hotchk155/Voici-Le-Strum/images/DSC02167.JPG

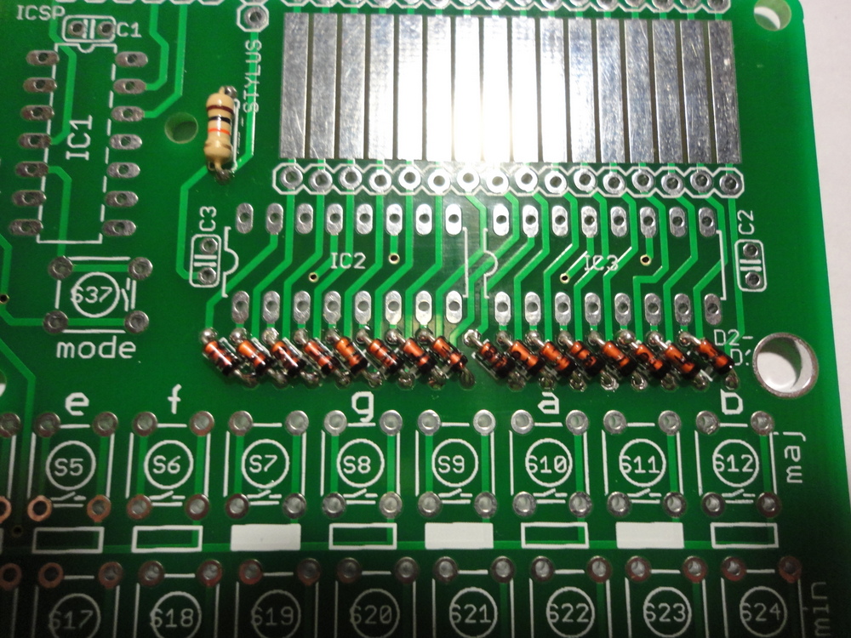
images/DSC02167.JPG
