hotchk155/Voici-Le-Strum/images/Dsc02171.jpg

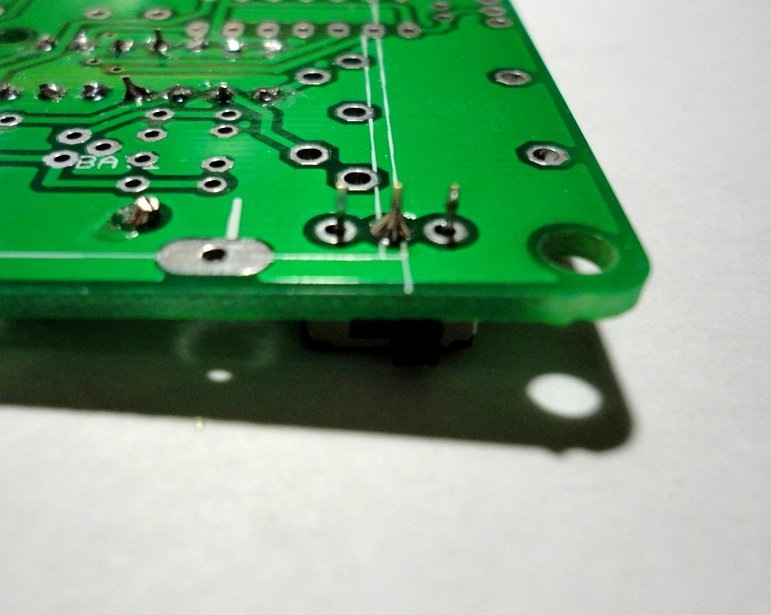
images/Dsc02171.jpg
