hotchk155/Voici-Le-Strum/README.md

LE STRUM is a MIDI strummed chord control surface built around the PIC16F1825 microcontroller. 

The Le Strum documentation is at [http://six4pix.com/lestrum/](http://six4pix.com/lestrum/)
