hotchk155/Voici-Le-Strum/docs/quick ref.odt

Preset Patch (Hold MODE Button) | Command (Hold MODE Button) | Toggle Setting (Hold MODE Button) Single blink OFF, Double blink ON | LE STRUM QUICK REF V4

| | C | C# | D | D# | E | F | F# | G | G# | A | A# | B
MAJ | | Basic Strum Mode | | Guitar Strum Mode | | Guitar Sustain Mode | Organ Buttons Mode | | Organ Buttons with Adds | | Organ Buttons with Adds/Retrig | | Load User Patch From EEPROM
MIN | | Play Note On Contact Make | Play Note On Contact Break | Guitar Open Chord Voicing | Added Notes (Sus4/6/9) | Sustain Chord Until Next Chord | Chromatic Scale On Pads | | Enable Organ Buttons On MIDI Ch 2 | Sustain O/B Until Next Chord | | Toggle Strum Direction | Save User Patch To EEPROM
DOM7 | | Damp Note On Contact Make | Damp Note On Contact Break | Repeat Guitar Chord At +1 Octave | Map Guitar Chord Bass Notes | Common Notes Sustain On Change | Diatonic Scale On Pads | Pentatonic Scale On Pads | | Common Notes Sustain On O/B | | Toggle Circle Of 5ths Mode | MIDI Panic (All Notes Off)
| | C | C# | D | D# | E | F | F# | G | G# | A | A# | B
C. of 5ths | | Db | Ab | Eb | Bb | F | C | G | D | A | E | B | F#

Special Chord Button Combinations ● MAJ + DOM7 = Major Seventh Chord ● MIN + DOM7 = Minor Seventh Chord ● MAJ + MIN = Diminished Triad ● MAJ + MIN + DOM7 = Augmented Triad | Added Notes (When enabled by Mode) ● Hold chord and press top row button to right = Sus 4 ● Hold chord and press middle row button to right = Add 6 ● Hold chord and press bottom row button to right = Add 2/9 | ● Hold MODE and touch a pad with the stylus to set MIDI velocity ● Hold MODE at startup to flash firmware version number ● Strum output on MIDI channel 1 at controllable velocity ● Organ button output on MIDI channel 2 at full velocity
