hotchk155/Voici-Le-Strum/docs/le strum.odt

Le Strum is a MIDI strum controller

Stop playing when

As soon as chord button is pressed, the notes of the chord will play on MIDI channel 2 and will stop when the button is release

| OFF | ON
Pluck Mode | Note starts to play when a chord is held and stylus touches the note. Note stops playing when stylus stops touching the note

Added notes

Press higher note on row #1 – sus4

Press higher note on row #2 – add6

Press higher note on row #3 – add9

Stacked triads mode

Guitar chord mode

Alternate with octave

Notes stop after chord is released. If changing to another chord, unmatched notes are muted

Notes continue to ring after chord is released but when a new chord is pressed, unmatched notes are muted

Guitar

PLUCK

RING ON

ADDED NOTES

Mute Guitar

PLUCK

ADDED NOTES

Stacked Triads

PLUCK OFF

RING ON

ADDED NOTES

Muted Stacked Triads

PLUCK OFF

ADDED NOTES

Le Strum has 7 patches (C, D, E, F, G, A, B from left to right on the keyboard)

To switch between patches simply hold the MODE button and press one of the chord buttons in the top row for notes C, D, E, F, G, A or B. When selected, the MODE LED will flash a sequence of flashes indicating the selected patch, for a total of three repetitions of the sequence.

C | 1
D | 2
E | 3
F | 4
G | 5
A | 6
B | 7

The default patches are as follows

The patches can be customised. To do this you need to hold down the MODE button before powering on LE STRUM. This will enter patch edit mode.

In patch edit mode, select a patch to edit by holding MODE and pressing one of the top row chord buttons C,D,E,F,G,A,B. During programming mode the MODE LED blinks to indicate the patch that is being edited. You can change to another patch by holding MODE and pressing a different top row chord key.

Each patch has a number of settings associated with it. When you have selected a patch you can manipulate its settings as follows

- To view a setting press the top row chord button corresponding to the setting. The MODE LED will show steady ON or OFF
- To turn a setting ON press the top row chord button corresponding to the setting
- To turn a setting OFF press the top row chord button corresponding to the setting

To save settings to the current patch, press and hold MODE until it lights steadily for ~1s. Once all saves are done, you can power down LE STRUM and power back up for normal operation

Chord Mapping Options

VELOCITY

MIDI velocity for strumming can be controlled by holding the MODE button while touching one of the pads with the stylus. The first (leftmost) pad sets MIDI velocity to its minimum value and each pad increases the velocity up to its maximum value on the right most pad. The selected velocity stays effective until LE STRUM is switched off or a new velocity is chosen.

DYNAMICS

Pluck Mode: Start playing note when stylus breaks contact with pad.

Sustain Mode: Start playing note when stylus makes contact with pad.

Pluck/Damp Mode: Start playing note when stylus breaks contact with pad and stop note playing when stylus touches the pad again

Organ Mode: Start playing note when stylus makes contact with pad and stop note playing when stylus breaks contact with pad

Chord Setup Options

ORGAN BUTTONS

ON: The chord start to play when the chord button is first pressed, even when no strumming has taken place. When buttons are released the behaviour depends on the RING ON settng.

OFF: When changing chords, all notes from the previous chord are stopped

Organ button mode plays only the chord triad and higher octave of the selected chord.

ADDED NOTES

ON: While a chord is held, pressing another chord button further up the scale (to the right) will add notes to the chord. Row 1 = sus4, row 2 = add6, row 3 = add9.

Note that there some limitations to the use of added notes; obviously there is no higher button for the top "B" column, and the mapping of the chord notes to strings will change, with the root note playing again when the string corresponding to the column of the highest button is played.

OFF: The chord in the lowest column is used. Buttons held in any column to the right (higher up the scale) are ignored. This is useful when you want to change from one chord to another without releasing the first.

COMMON NOTE SUSTAIN

OFF: Changing from one chord to another will always stop all notes in the previous chord before starting notes in the new chord.

ON: When changing from one chord to another (without releasing the chord buttons) any notes which are common to both chords are not stopped but continue to ring.

RING ON

OFF: When all chord buttons are released, all notes will be stopped

ON: When all chord buttons are released, any notes still playing will ring on until a new chord is pressed (and will then be subject to common note sustain setting)

GUITAR MODE

ON: Typical guitar chord fingerings are used when mapping notes to the pads. The lowest 6 pads are standard register and the topmost 6 pads are one octave higher. The middle 2 pads are inactive. Depending on the chosen chord other pads may be inactive too (corresponding to the damped strings in the usual guitar chord fingering)

OFF: Notes of a chord are mapped to the pads using the stacked triads approach. All pads are active.

STRING MAPPING

NORMAL: Chord notes are assigned to pads 1 by 1

OCTAVE PAIRING: Chord notes are interlaced with notes 1 octave higher (i.e. Every other pad plays a note 1 octave higher than the pad to its left). The idea is to have something similar to a 12 string guitar.

NOTE DOUBLING: Chord notes are duplicated (i.e. Every other pad plays the same note as the pad to its left).

NOTE SPREAD: Chord notes are separated with a dead string (i.e. Every other pad is not mapped to any note).

In Guitar mode any mapping other than "normal" will disable the higher chord mapping.

- Le Strum outputs on MIDI channel 1 at the user controlled velocity
- Chord Buttons are output on MIDI channel 2 at full velocity

Play on Make | Play on Break | Guit | Add | Sus | Scale | | | | Drone | Sus Drone | Save
Stop on Make | Stop on Break | Guit2 | Bass | Sus Comm | Dia | Pent | | | | Sus Drone Comm | Load
