hotchk155/Voici-Le-Strum/hardware/board_render.png

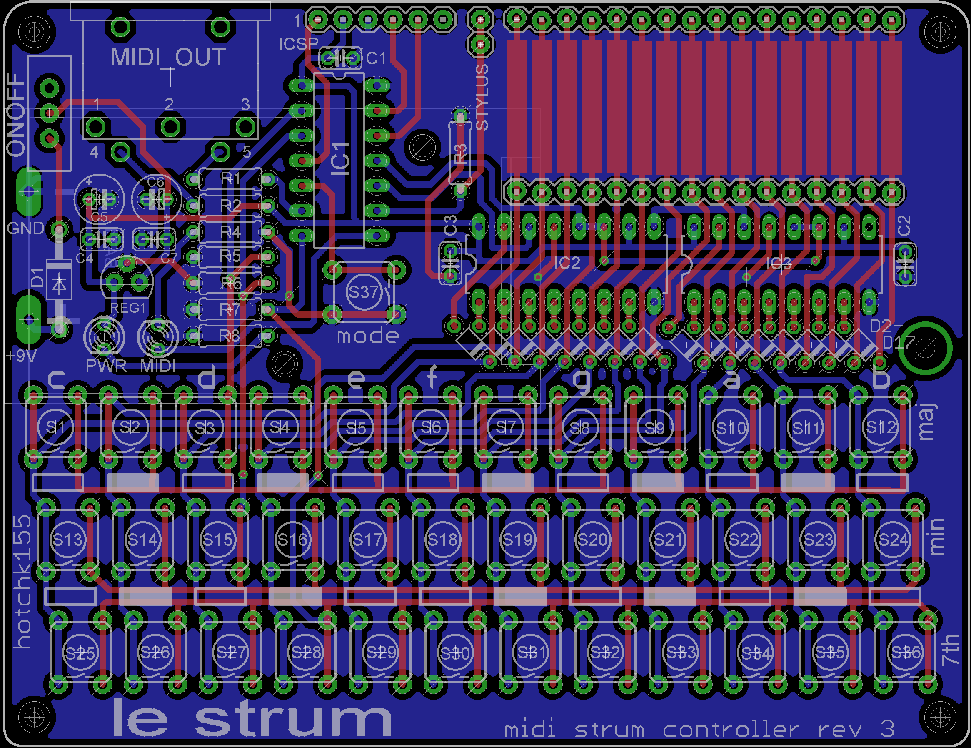
hardware/board_render.png
