hotchk155/Voici-Le-Strum/hardware/schematic_render.png

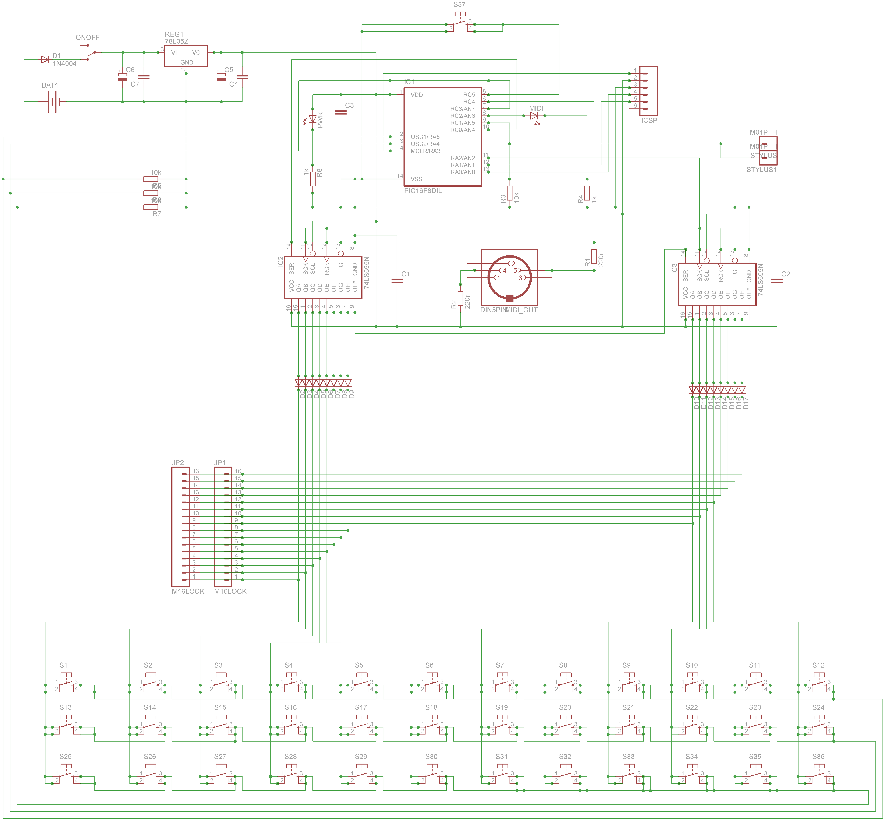
hardware/schematic_render.png
