hotchk155/Voici-Le-Strum/images/Dsc02149.jpg

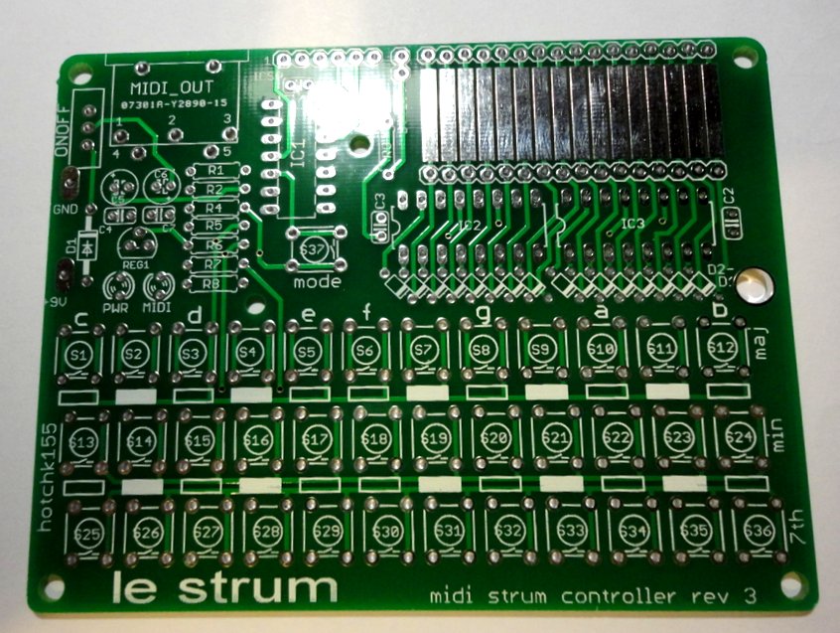
images/Dsc02149.jpg
