hotchk155/Voici-Le-Strum/images/Dsc02150.jpg

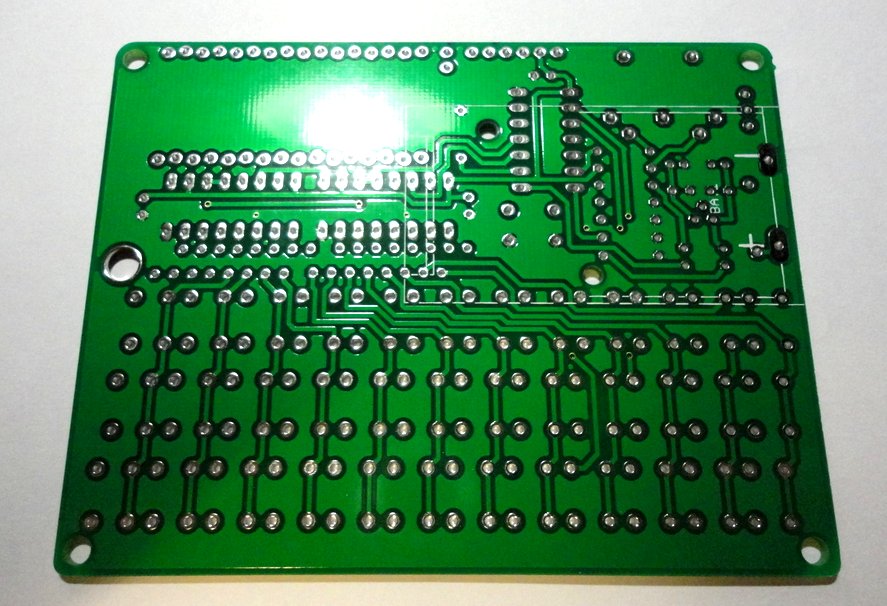
images/Dsc02150.jpg
