hotchk155/Voici-Le-Strum/images/Dsc02153.jpg

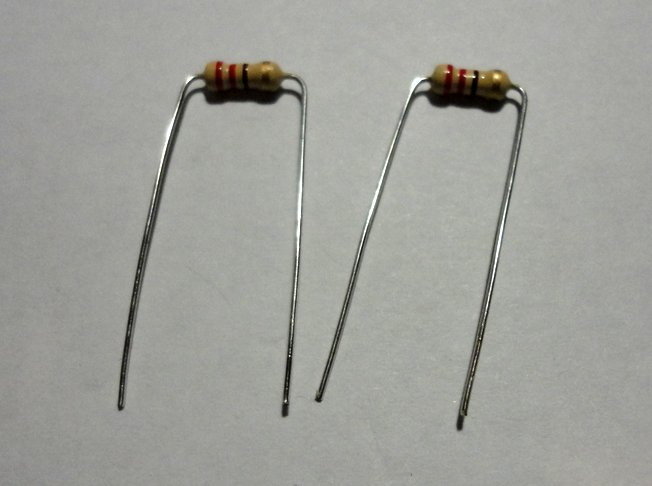
images/Dsc02153.jpg
