hotchk155/Voici-Le-Strum/images/Dsc02159.jpg

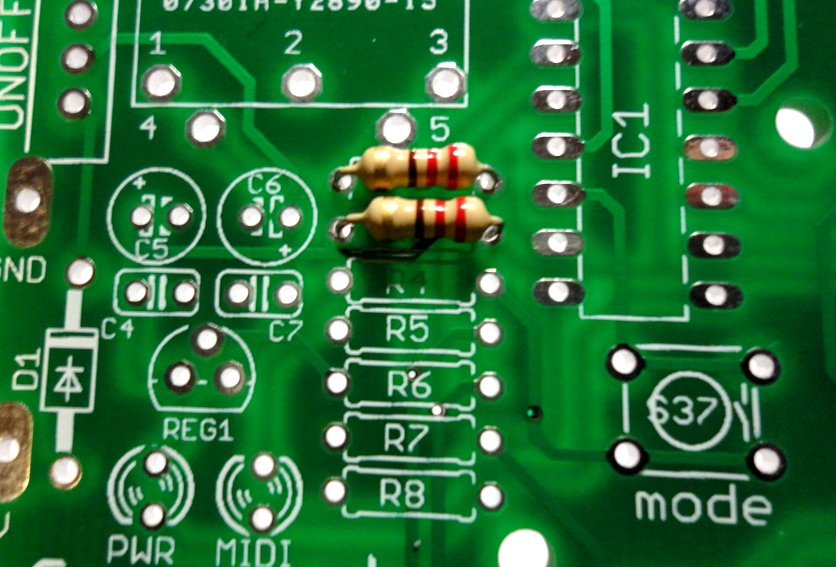
images/Dsc02159.jpg
