hotchk155/Voici-Le-Strum/images/Dsc02160.jpg

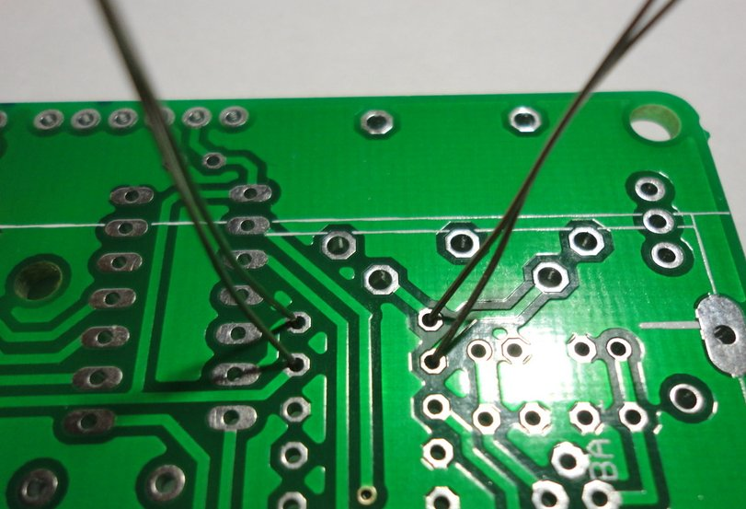
images/Dsc02160.jpg
