hotchk155/Voici-Le-Strum/images/Dsc02161.jpg

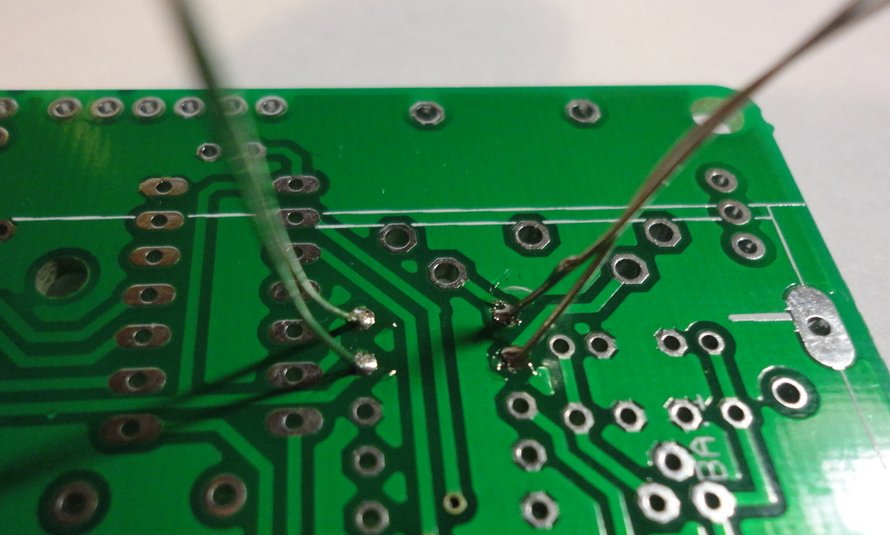
images/Dsc02161.jpg
