hotchk155/Voici-Le-Strum/images/Dsc02162.jpg

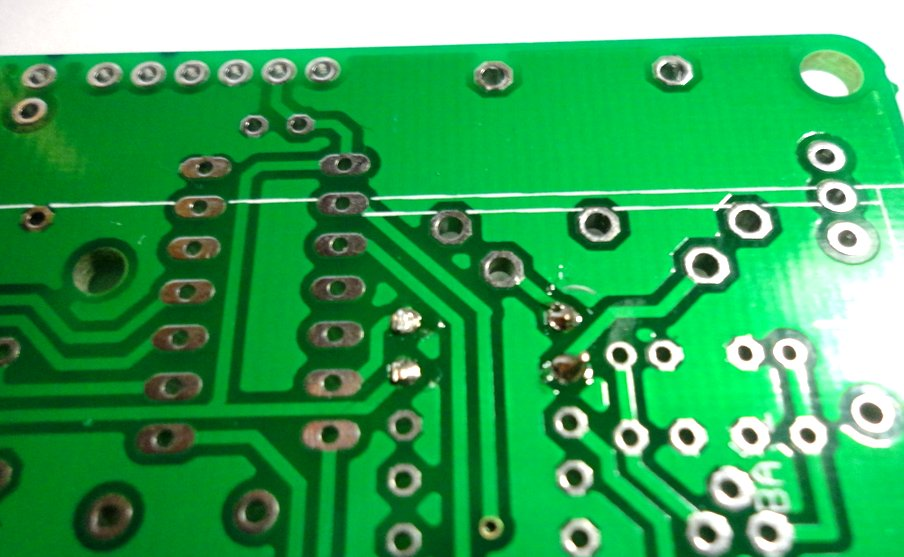
images/Dsc02162.jpg
