hotchk155/Voici-Le-Strum/images/Dsc02163.jpg

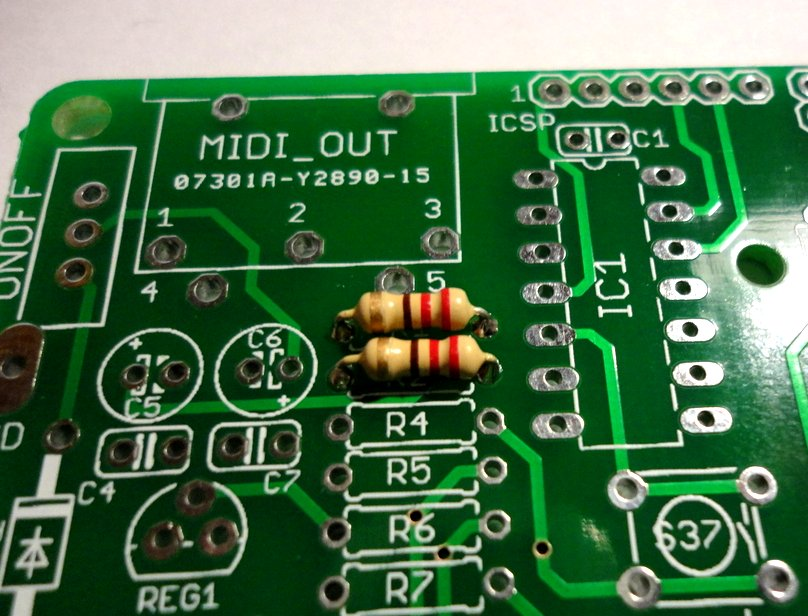
images/Dsc02163.jpg
