hotchk155/Voici-Le-Strum/images/Dsc02164.jpg

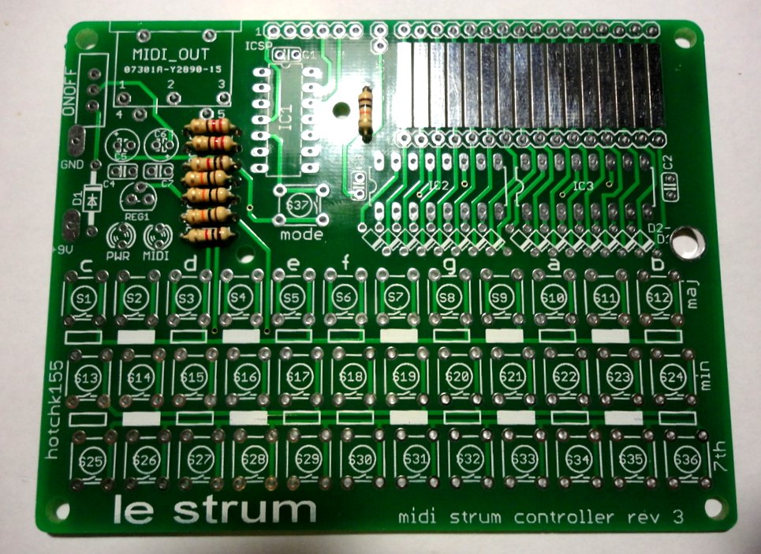
images/Dsc02164.jpg
