hotchk155/Voici-Le-Strum/images/Dsc02172.jpg

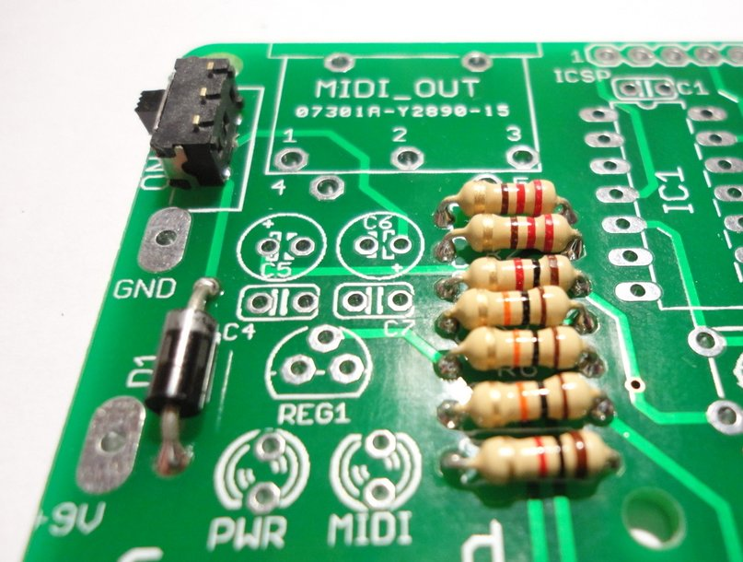
images/Dsc02172.jpg
