hotchk155/Voici-Le-Strum/images/Dsc02174.jpg

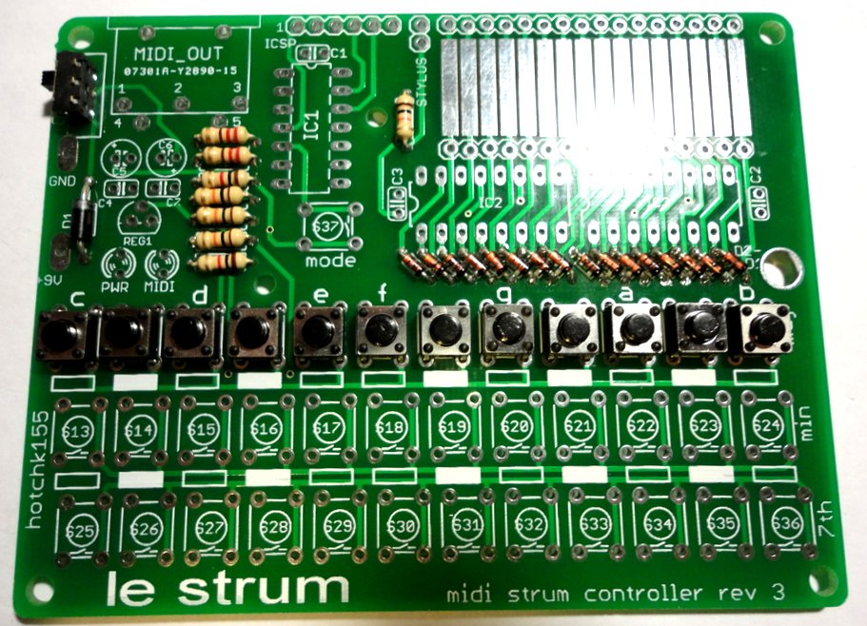
images/Dsc02174.jpg
