hotchk155/Voici-Le-Strum/images/Dsc02175.jpg

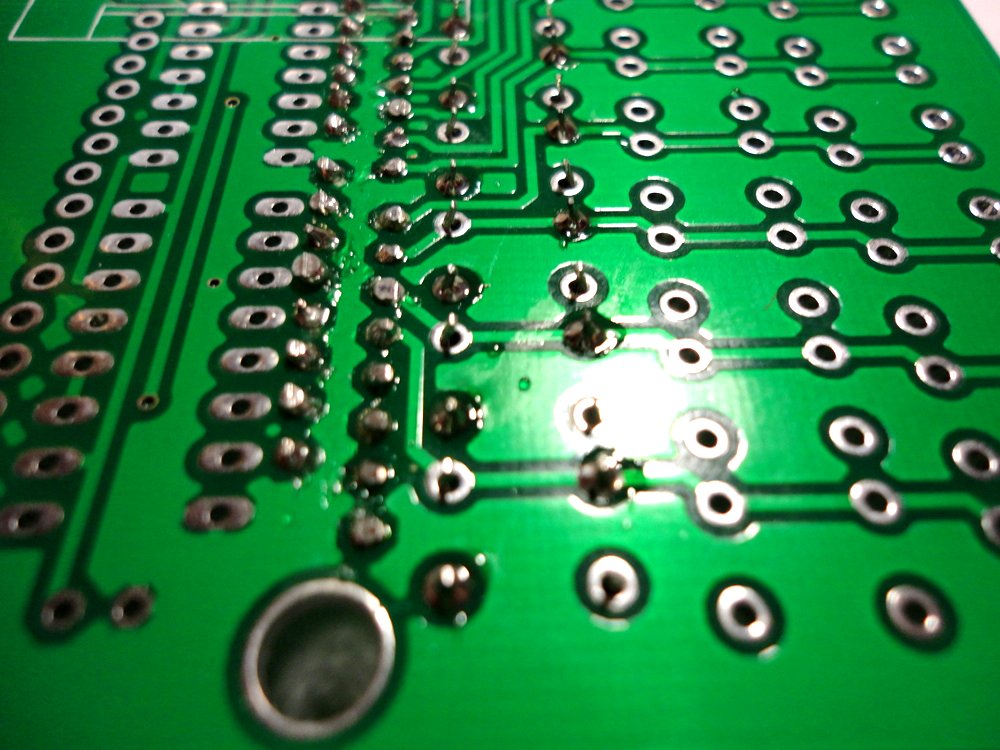
images/Dsc02175.jpg
