hotchk155/Voici-Le-Strum/images/Dsc02176.jpg

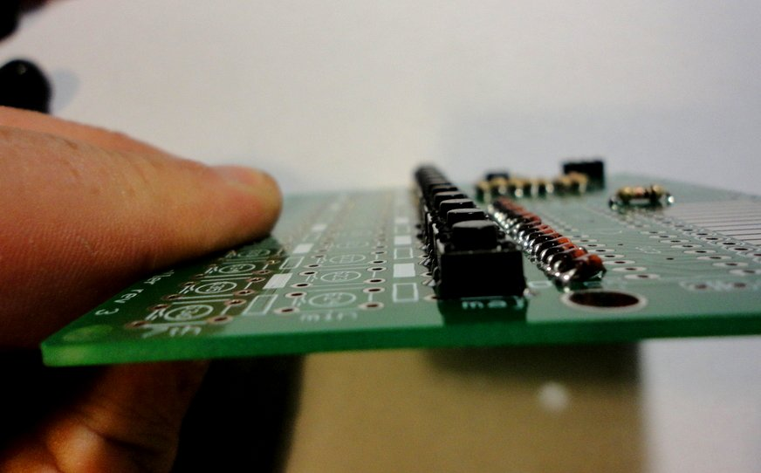
images/Dsc02176.jpg
