hotchk155/Voici-Le-Strum/images/Dsc02182.jpg

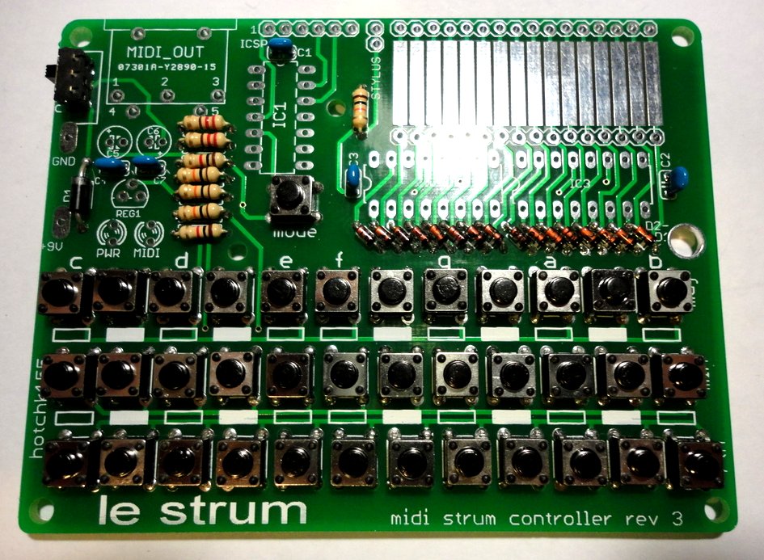
images/Dsc02182.jpg
