hotchk155/Voici-Le-Strum/images/Dsc02185.jpg

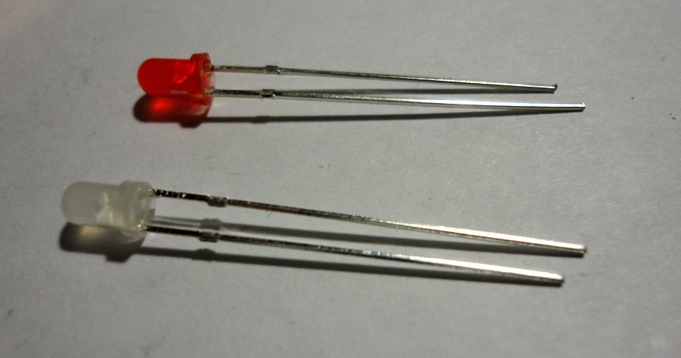
images/Dsc02185.jpg
