hotchk155/Voici-Le-Strum/images/Dsc02186.jpg

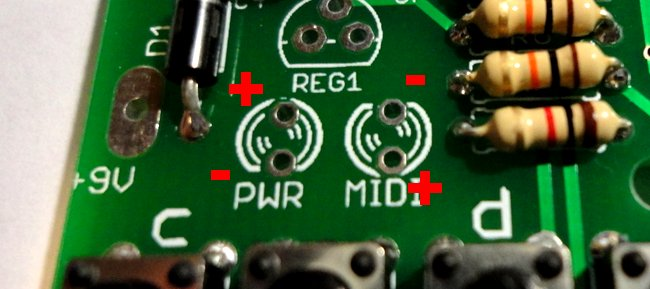
images/Dsc02186.jpg
