hotchk155/Voici-Le-Strum/images/Dsc02187.jpg

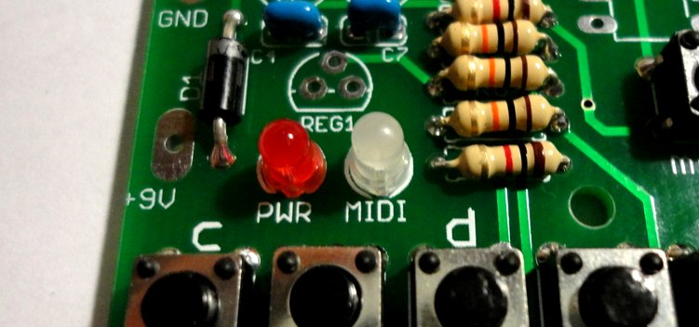
images/Dsc02187.jpg
