hotchk155/Voici-Le-Strum/images/Dsc02189.jpg

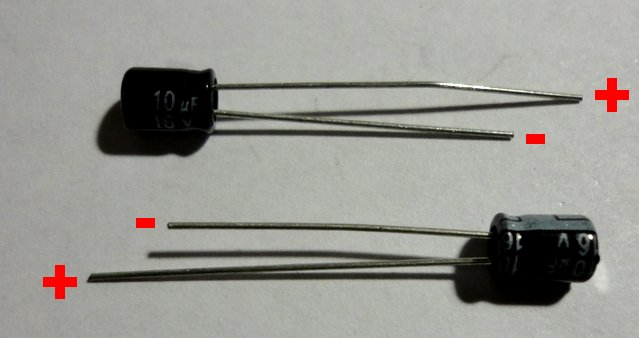
images/Dsc02189.jpg
