hotchk155/Voici-Le-Strum/images/Dsc02191.jpg

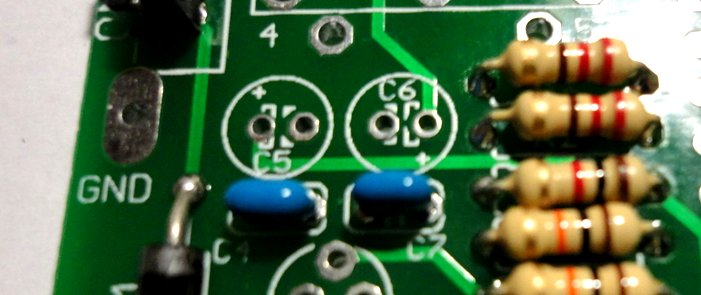
images/Dsc02191.jpg
