hotchk155/Voici-Le-Strum/images/Dsc02194.jpg

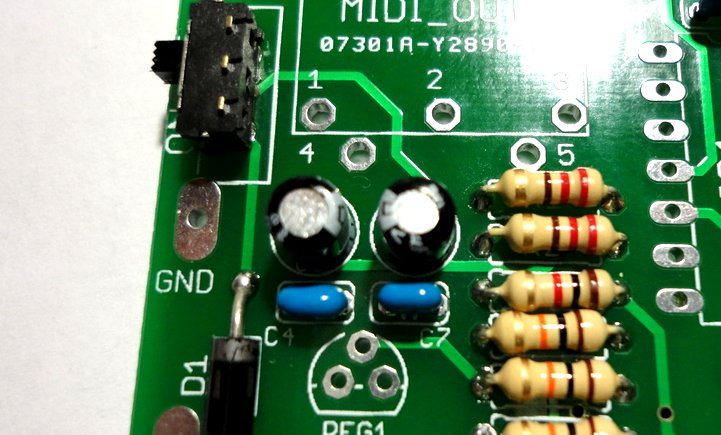
images/Dsc02194.jpg
