hotchk155/Voici-Le-Strum/images/Dsc02195.jpg

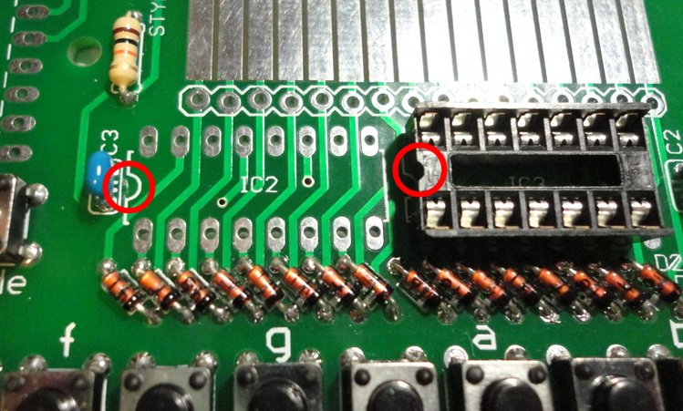
images/Dsc02195.jpg
