hotchk155/Voici-Le-Strum/images/Dsc02200.jpg

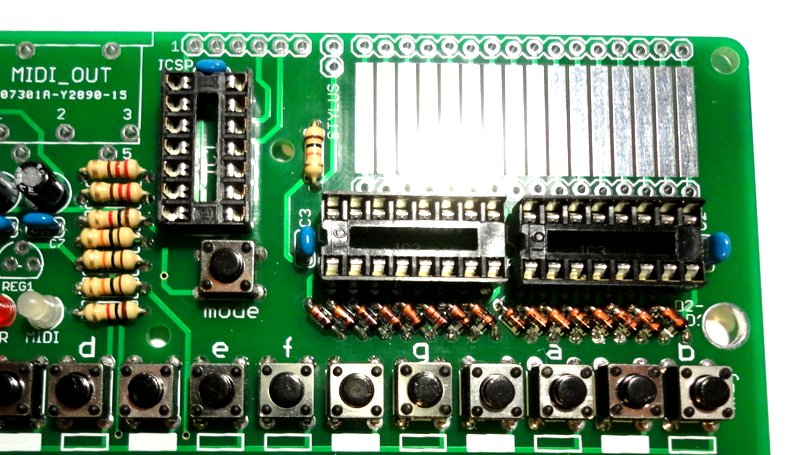
images/Dsc02200.jpg
