hotchk155/Voici-Le-Strum/images/Dsc02203.jpg

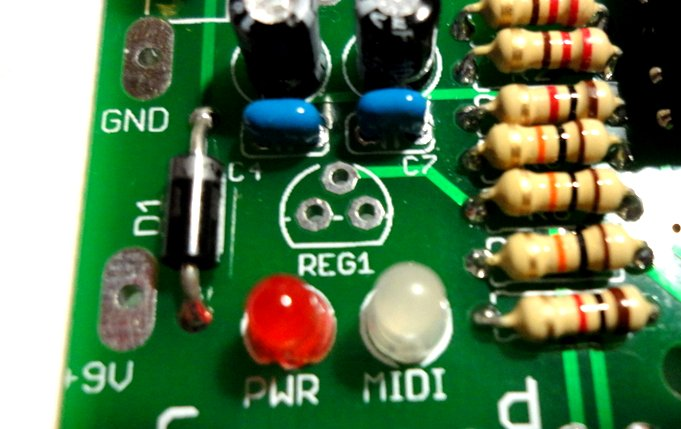
images/Dsc02203.jpg
