hotchk155/Voici-Le-Strum/images/Dsc02204.jpg

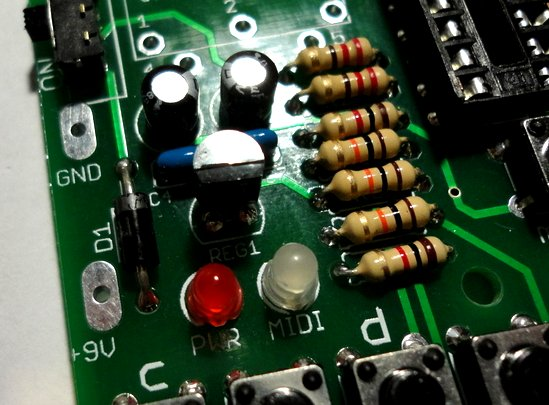
images/Dsc02204.jpg
