hotchk155/Voici-Le-Strum/images/Dsc02206.jpg

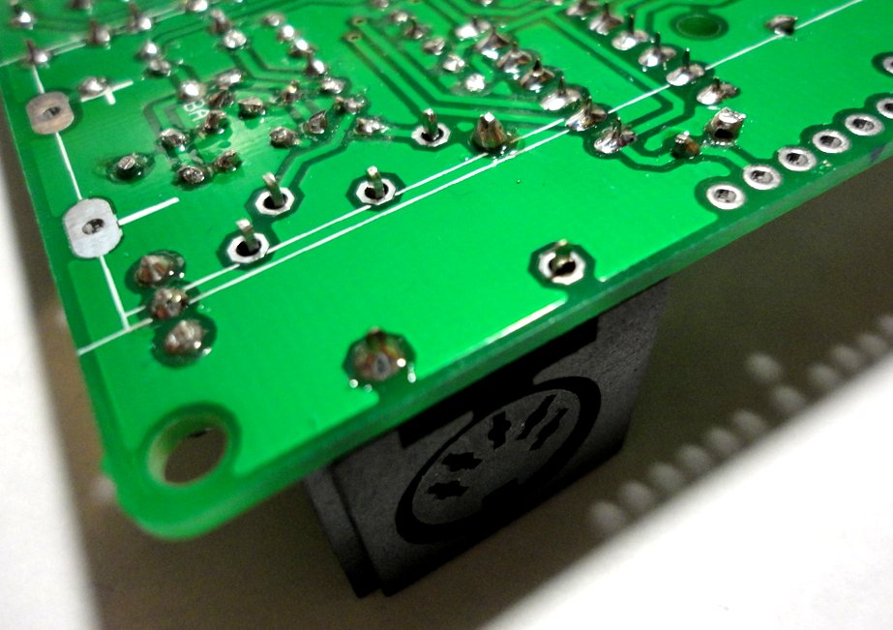
images/Dsc02206.jpg
