hotchk155/Voici-Le-Strum/images/Dsc02207.jpg

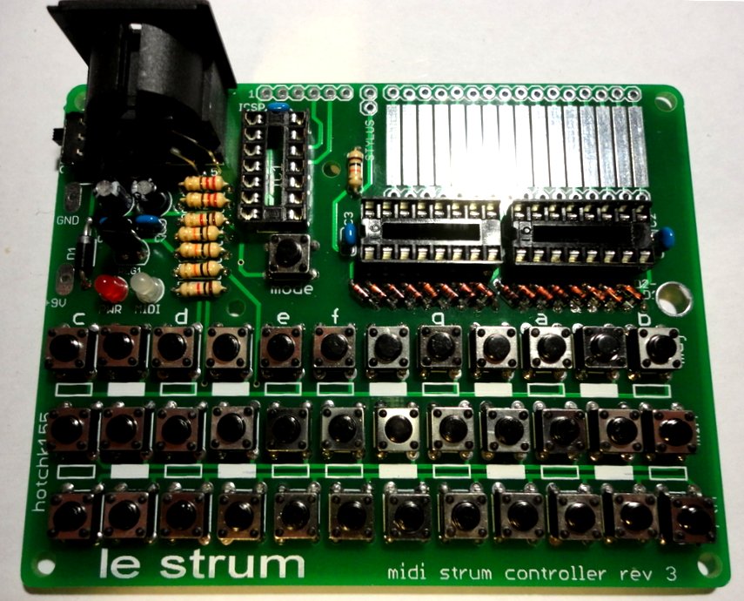
images/Dsc02207.jpg
