hotchk155/Voici-Le-Strum/images/Dsc02209.jpg

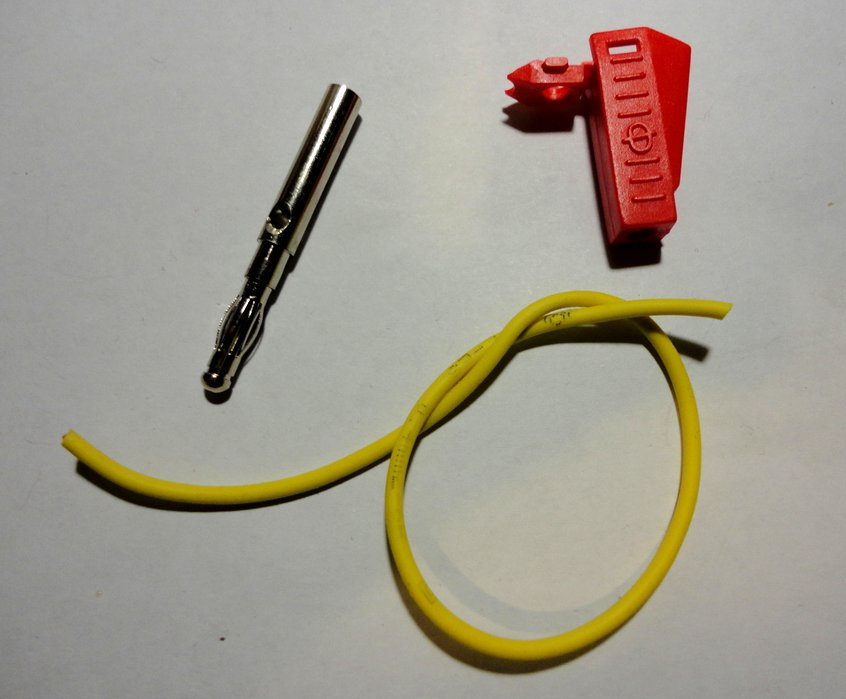
images/Dsc02209.jpg
