hotchk155/Voici-Le-Strum/images/Dsc02211.jpg

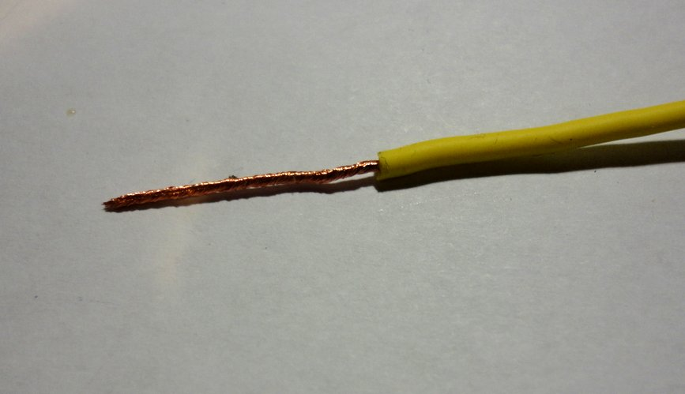
images/Dsc02211.jpg
