hotchk155/Voici-Le-Strum/images/Dsc02213.jpg

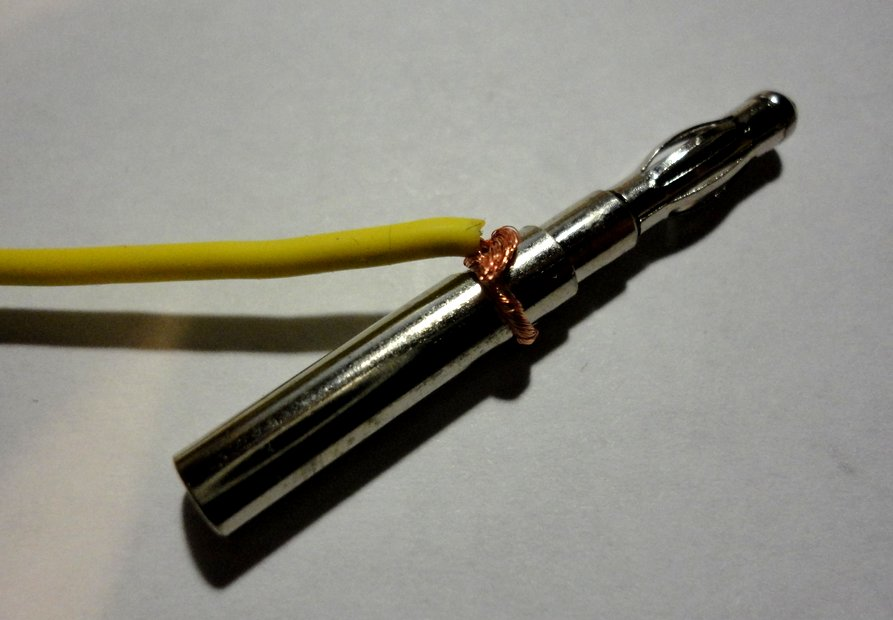
images/Dsc02213.jpg
