hotchk155/Voici-Le-Strum/images/Dsc02218.jpg

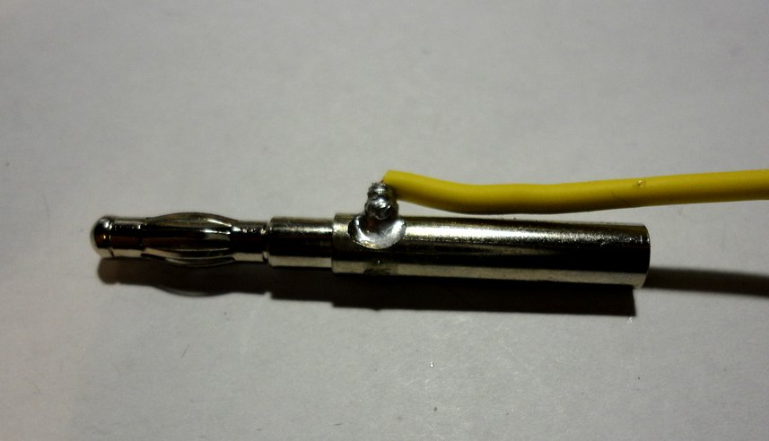
images/Dsc02218.jpg
