hotchk155/Voici-Le-Strum/images/Dsc02220.jpg

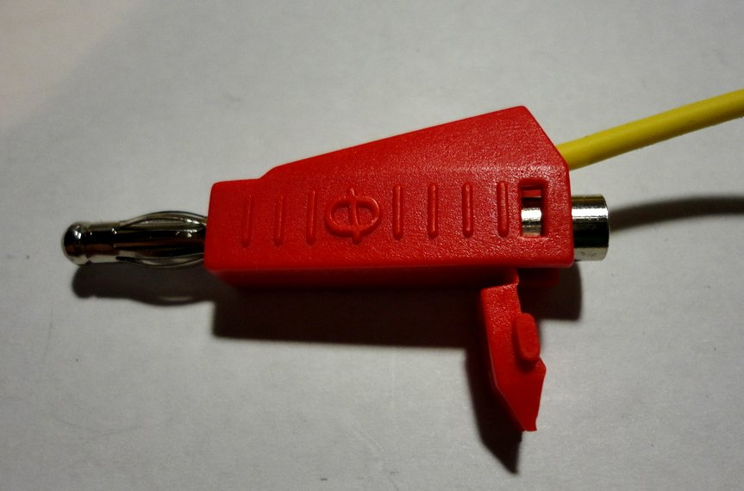
images/Dsc02220.jpg
