hotchk155/Voici-Le-Strum/images/Dsc02222.jpg

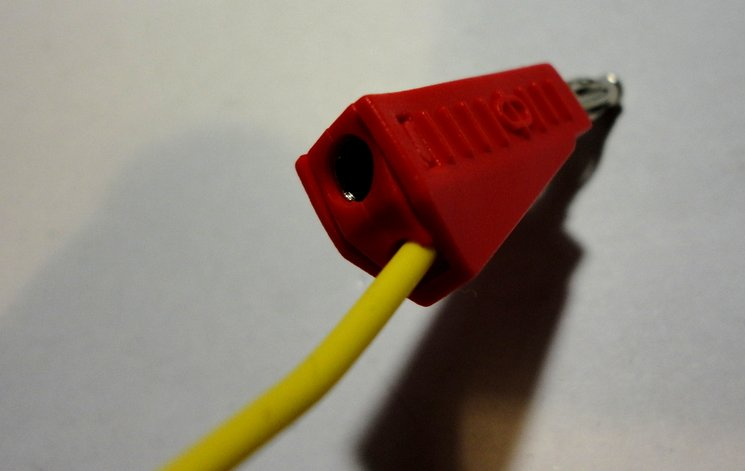
images/Dsc02222.jpg
