hotchk155/Voici-Le-Strum/images/Dsc02223.jpg

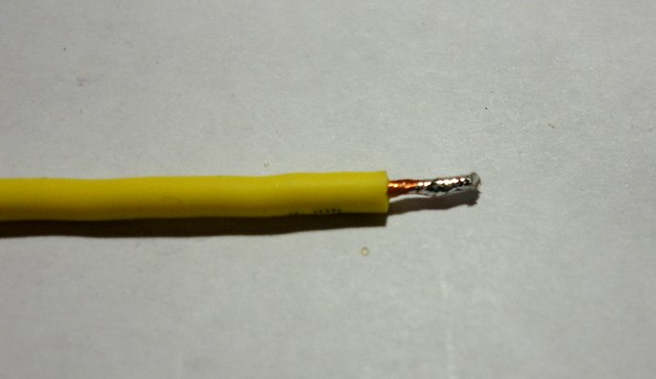
images/Dsc02223.jpg
