hotchk155/Voici-Le-Strum/images/Dsc02224.jpg

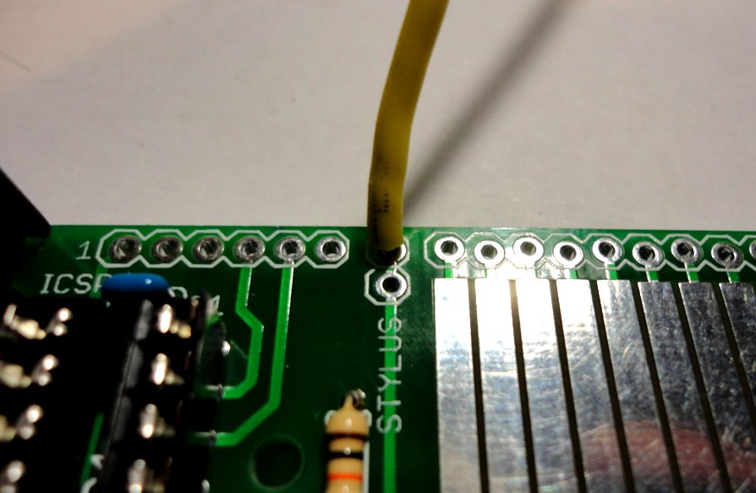
images/Dsc02224.jpg
