hotchk155/Voici-Le-Strum/images/Dsc02226.jpg

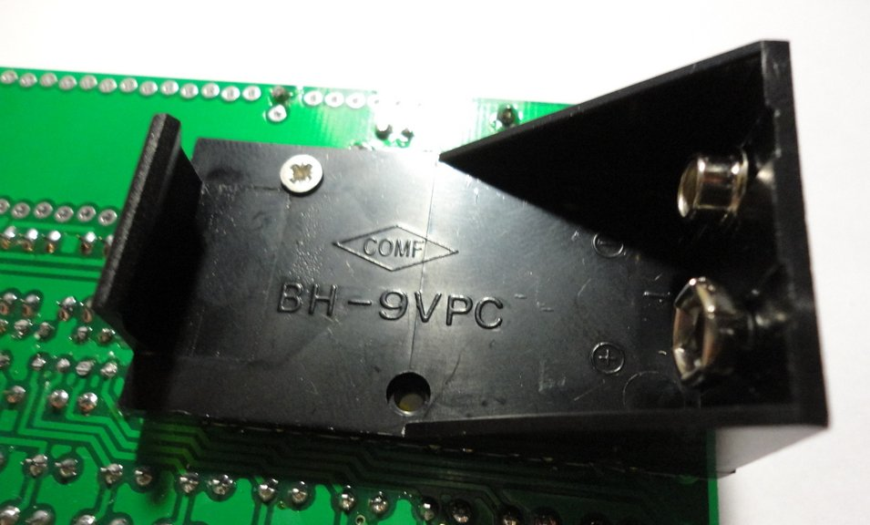
images/Dsc02226.jpg
