hotchk155/Voici-Le-Strum/images/Dsc02228.jpg

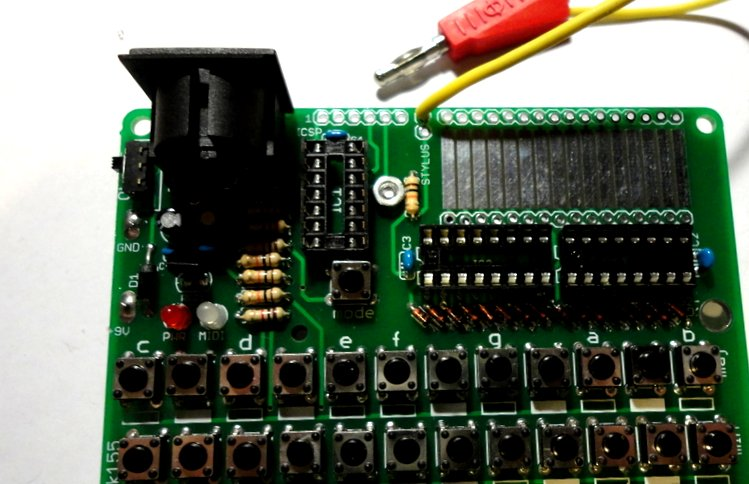
images/Dsc02228.jpg
