hotchk155/Voici-Le-Strum/images/Dsc02232.jpg

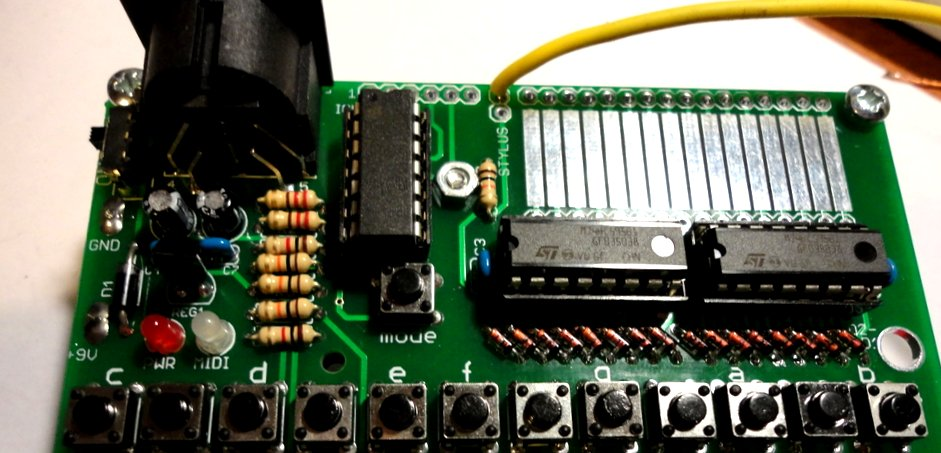
images/Dsc02232.jpg
