hotchk155/Voici-Le-Strum/images/Dsc02274.jpg

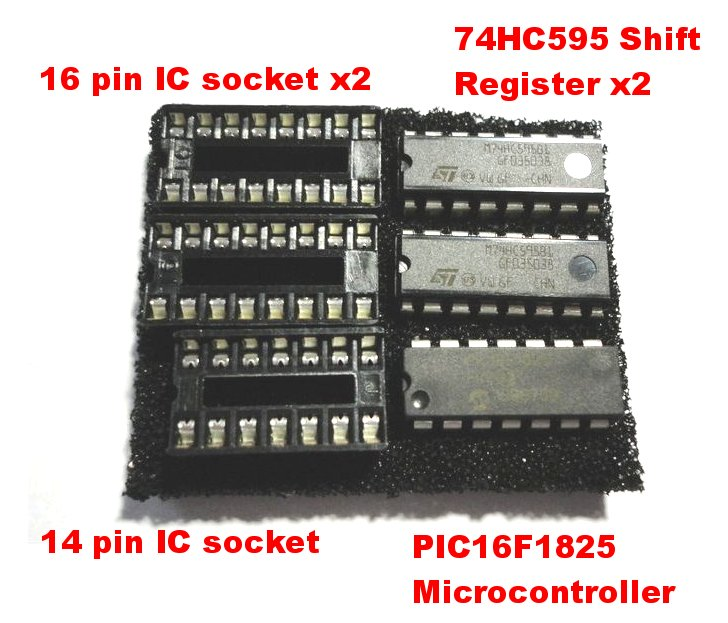
images/Dsc02274.jpg
