hotchk155/Voici-Le-Strum/images/Dsc02278.jpg

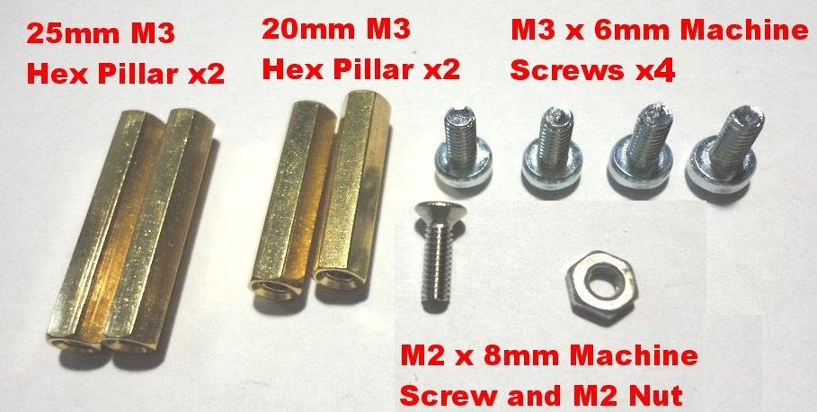
images/Dsc02278.jpg
