hotchk155/Voici-Le-Strum/images/Dsc02281.jpg

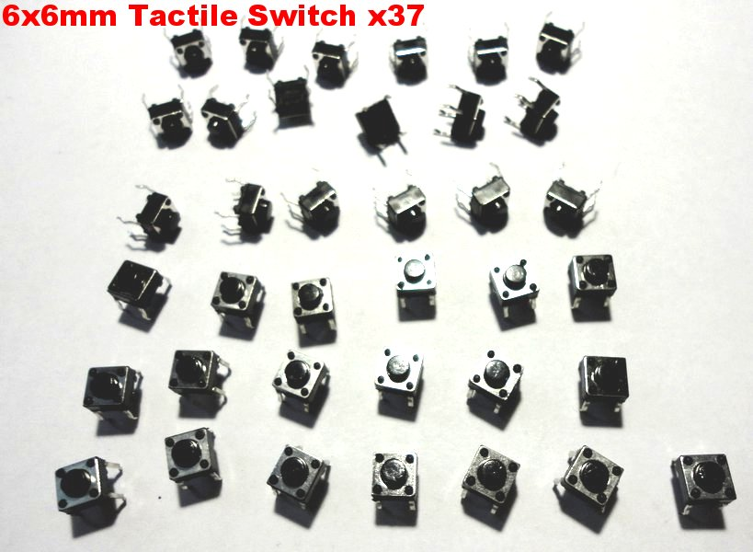
images/Dsc02281.jpg
