hotchk155/Voici-Le-Strum/images/Dsc02284.jpg

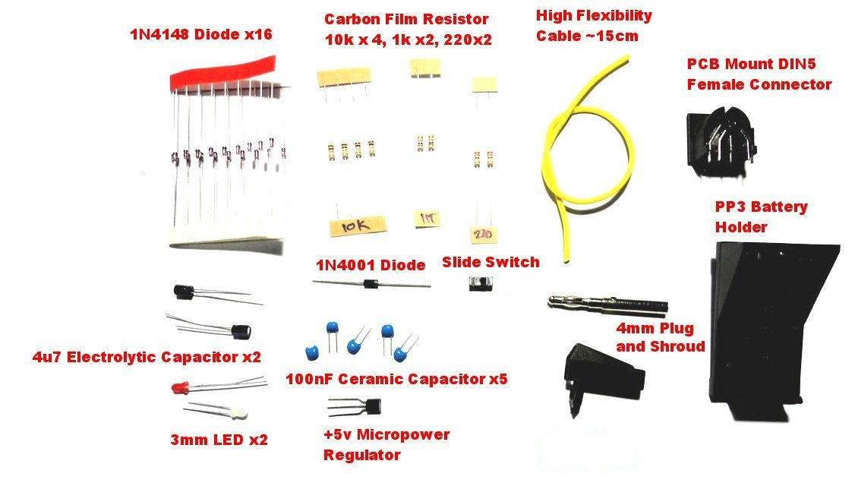
images/Dsc02284.jpg
