hotchk155/Voici-Le-Strum/images/Dsc02290.jpg

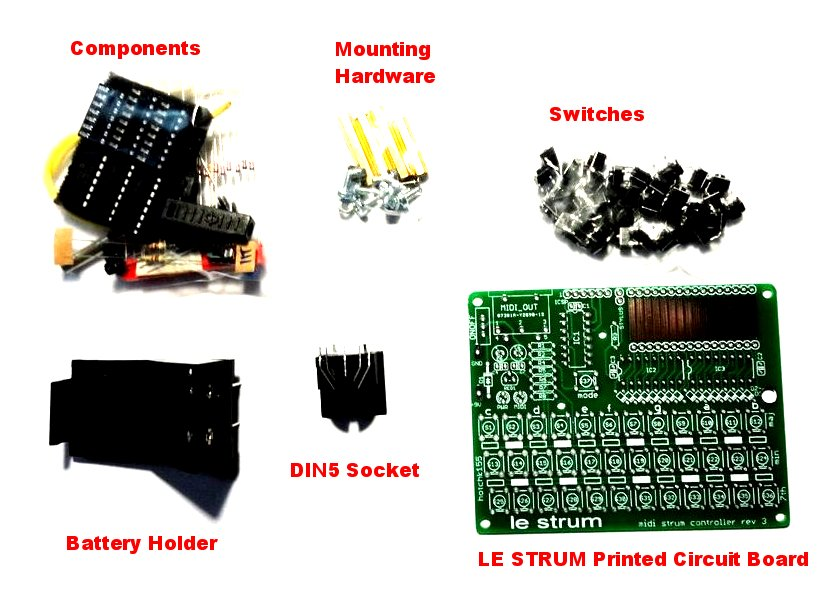
images/Dsc02290.jpg
