hotchk155/Voici-Le-Strum/images/mod_tips.png

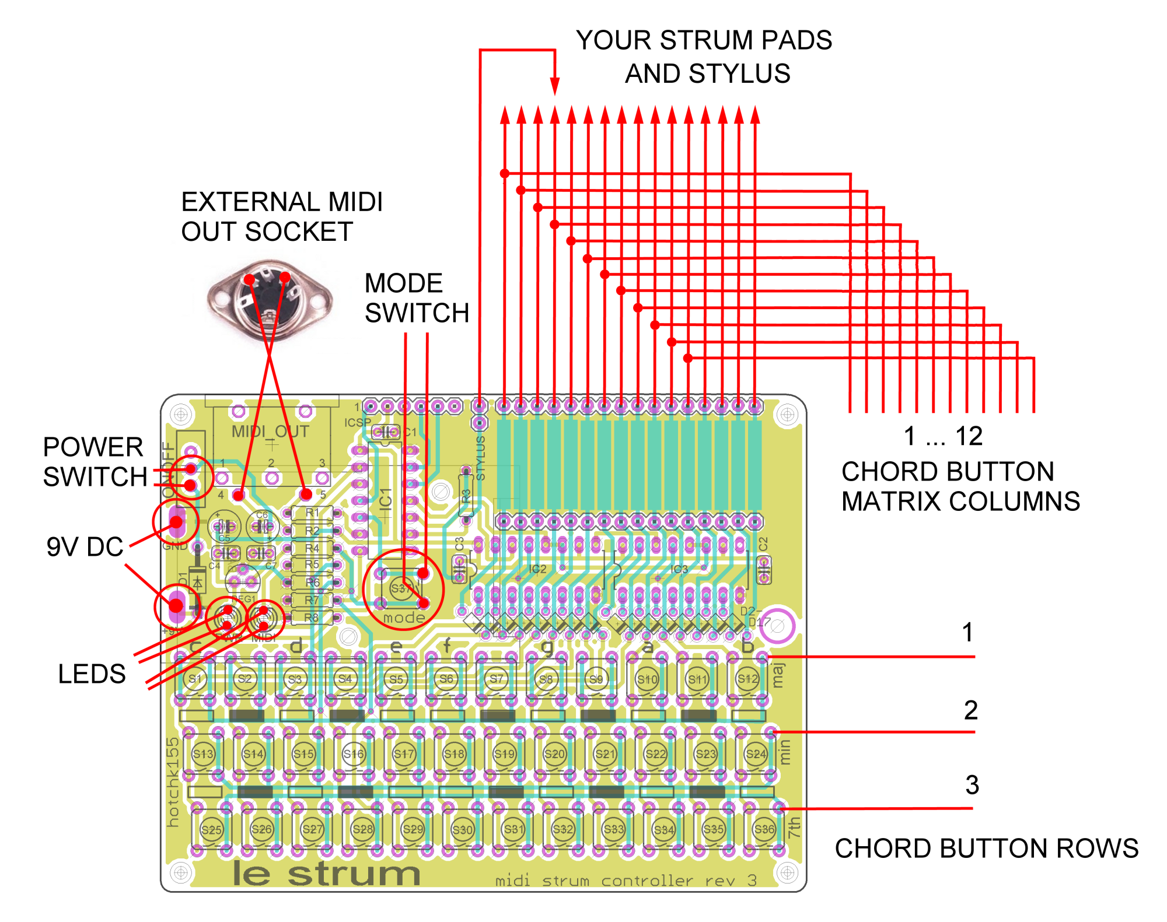
images/mod_tips.png
