hotchk155/Voici-Le-Strum/images/userpics1.JPG

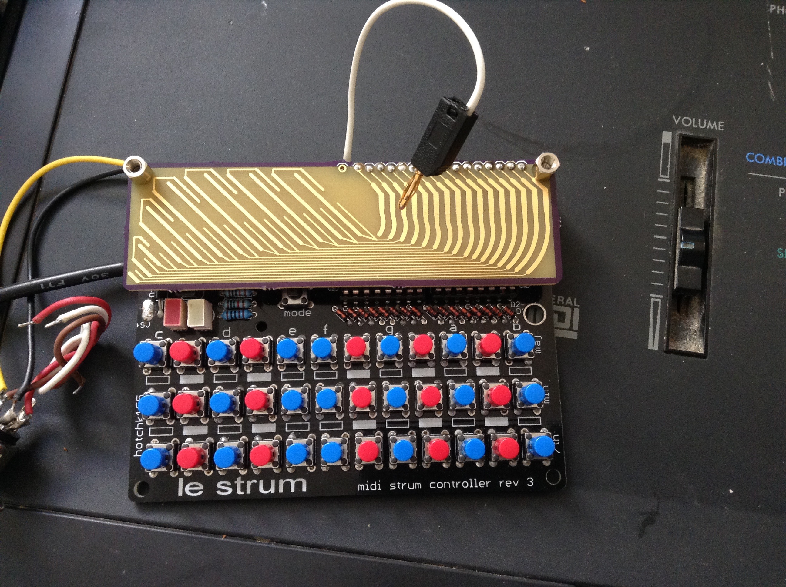
images/userpics1.JPG
