hotchk155/Voici-Le-Strum/images/userpics2.JPG

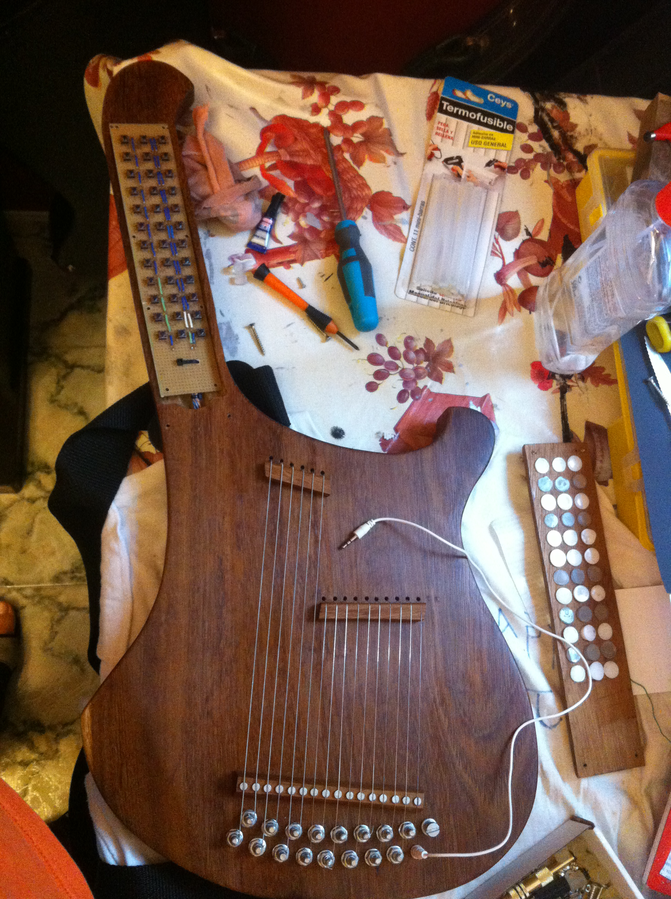
images/userpics2.JPG
