hotchk155/Voici-Le-Strum/images/userpics3.JPG

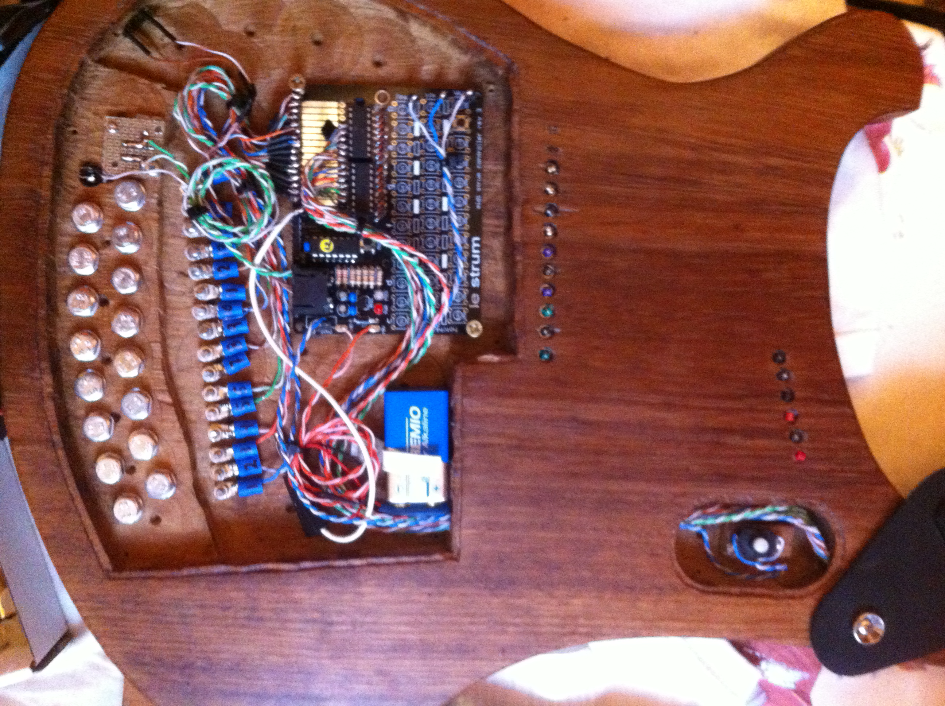
images/userpics3.JPG
