hotchk155/Voici-Le-Strum/images/userpics4.JPG

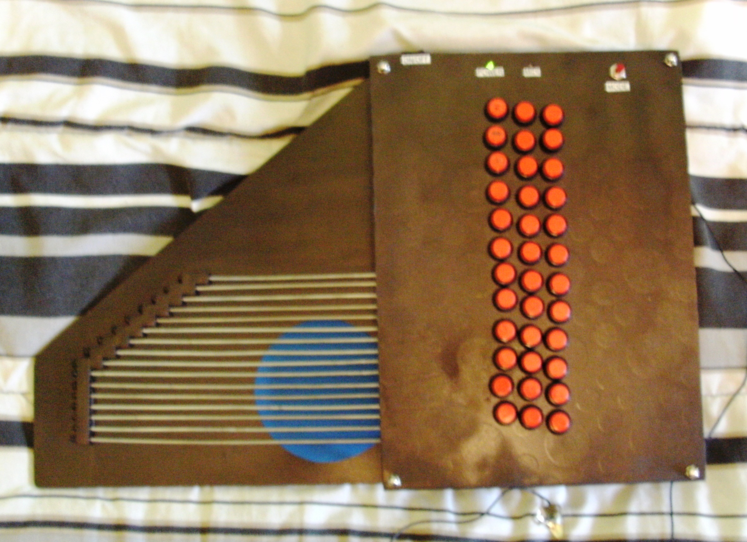
images/userpics4.JPG
