hotchk155/Voici-Le-Strum/images/userpics5.jpg

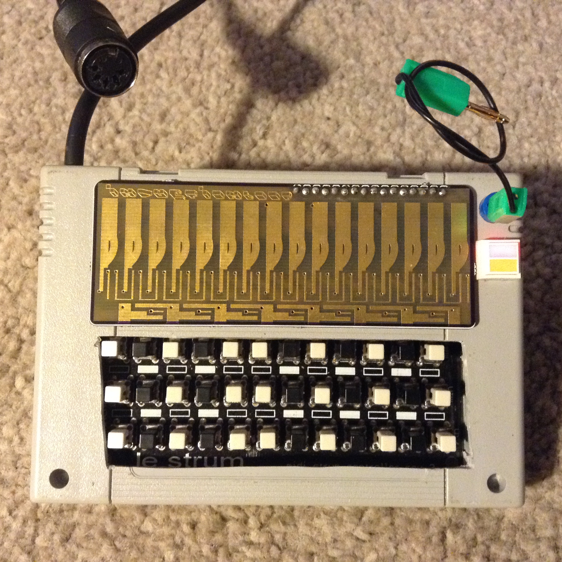
images/userpics5.jpg
