hotchk155/Voici-Le-Strum/images/userpics6.jpg

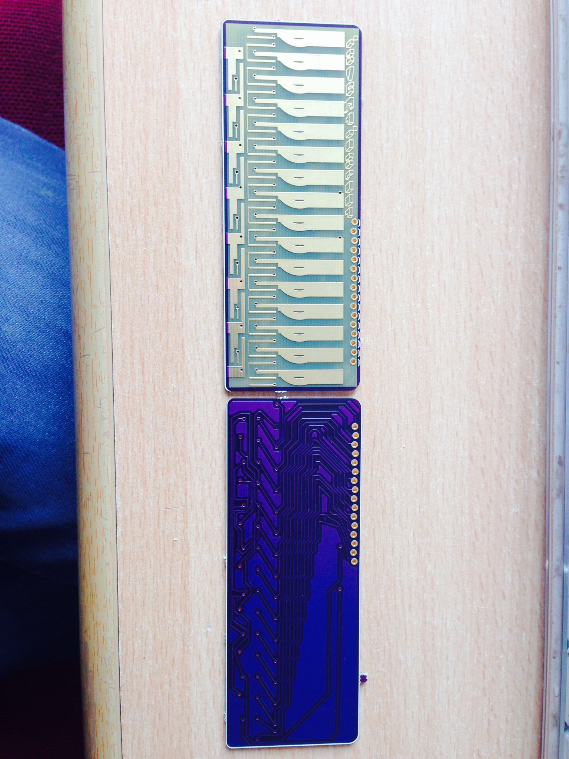
images/userpics6.jpg
