hotchk155/Voici-Le-Strum/images/userpics7.jpg

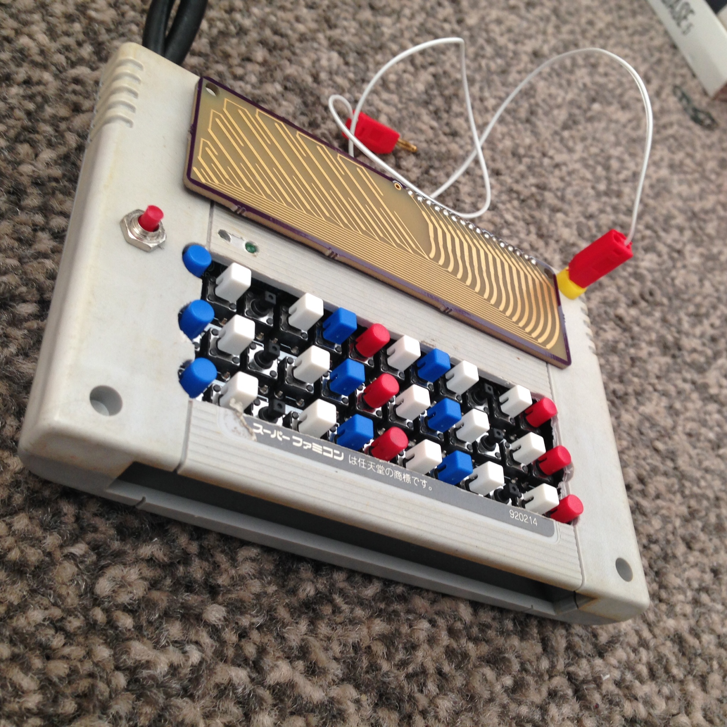
images/userpics7.jpg
