hotchk155/Voici-Le-Strum/images/userpics8.jpg

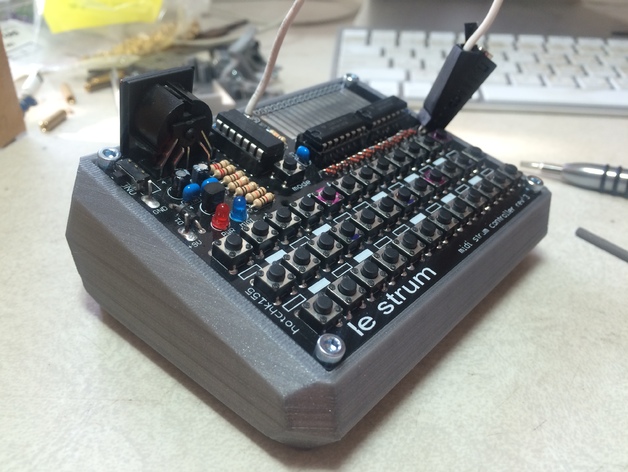
images/userpics8.jpg
