hotchk155/Voici-Le-Strum/le_grand_strum/www.png

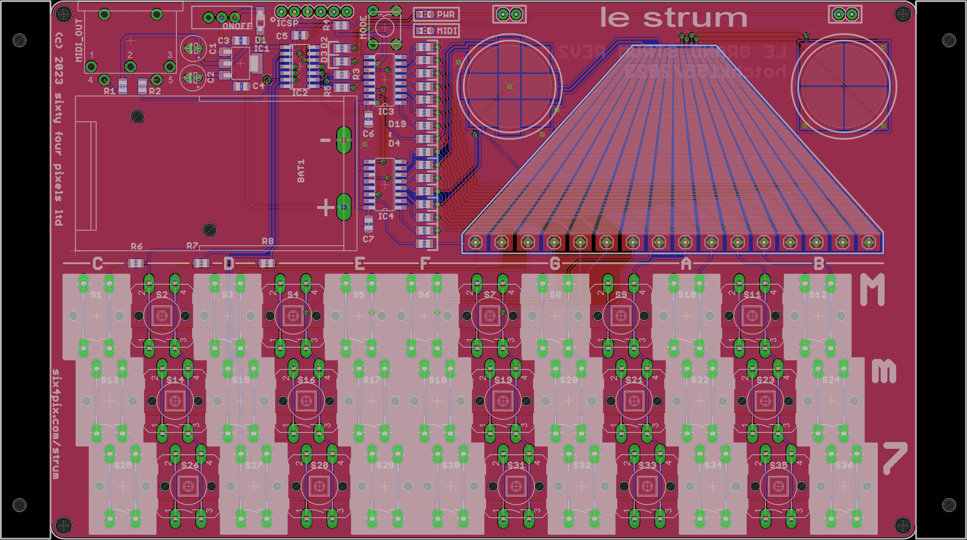
le_grand_strum/www.png
