hotchk155/Voici-Le-Strum/stand-du-strum/bom.txt

bottom plate 3mm
top plate 3mm
2 x side plate 3mm
2 x end plates 5mm

10 x M3 bolt 12mm length
10 x M3 nut
4 x M3 nylon spacer 3mm height
4 x rubber feet

17
