hotchk155/Voici-Le-Strum/docs/manual/img/parts.png

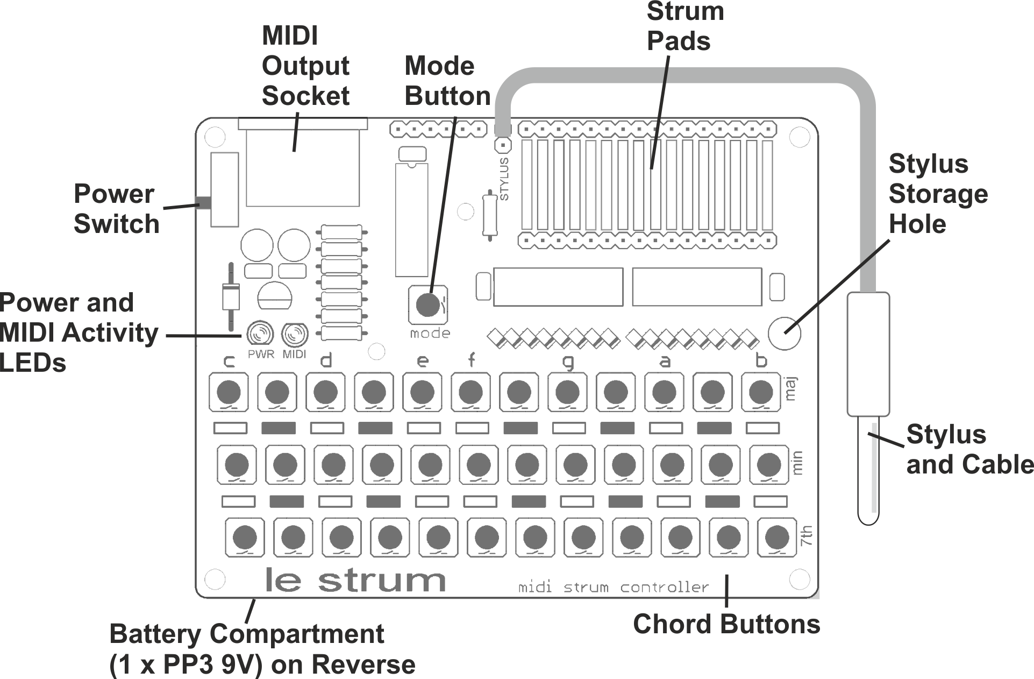
docs/manual/img/parts.png
