hotchk155/Voici-Le-Strum/stand-du-strum/stand-du-strum-3mm.dxf

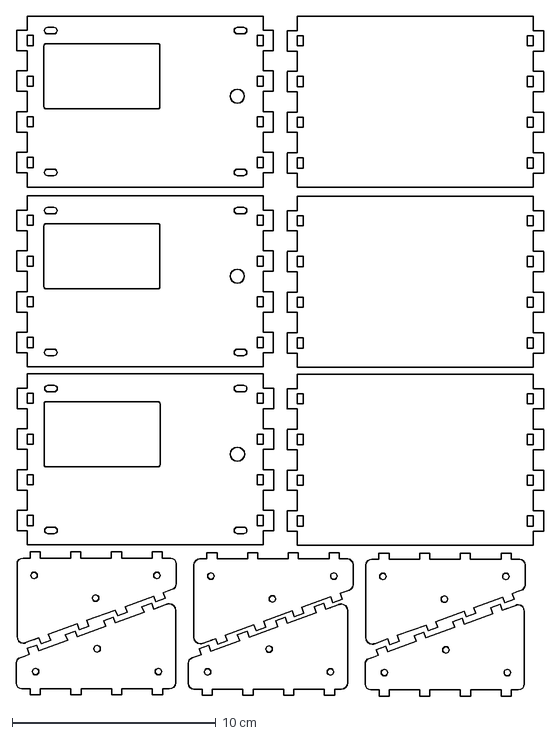
[picture p59: CAD file, 2015-04-12]
stand-du-strum/stand-du-strum-3mm.dxf
25.9 x 33.4 cm
