hotchk155/Voici-Le-Strum/stand-du-strum/stand-du-strum-5mm.dxf

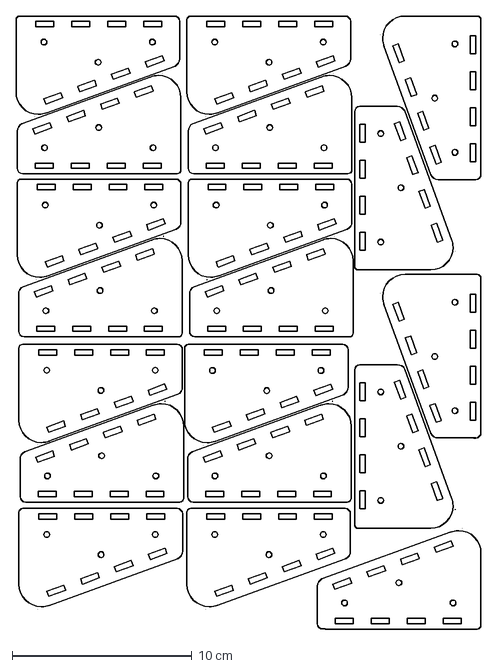
[picture p60: CAD file, 2015-04-12]
stand-du-strum/stand-du-strum-5mm.dxf
25.9 x 34.1 cm
