hotchk155/Voici-Le-Strum/(threads)

Thread 4 (2022-06-11):

Compatability with H-Pi Flash Synth?

RagingRoosevelt, 2022-06-11:
I was hoping to use my Flash Synth with Le Strum but I seem to be stumped.  Flash requires the MIDI port to follow the MIDI Manufacturer's Association spec.  Does Le Strum follow that spec?  In particular, this is the part of the spec that Flash cares about:

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

Is this unsupported?  Is there a way to get this to work?

hotchk155, 2022-06-11:
Hey, you can connect pin 2 of the MIDI out socket to ground if you want to be able to draw power from the MIDI signal lines. The easiest way is to scrape off some of the solder mask from the underside of the board beside pin 2 then add a blob of solder as shown in yellow below. You could also use wire between pin 2 and the battery GND connector.
***@***.***

I would not usually recommend trying to draw power this way since the Le Strum is battery powered and the 5V supply is via a micropower LDO regulator. This means if you try to draw too much current you could stress the regulator and/or reduce battery life. However if your Flash synth draws low current you could give it a try

You could also run from an AC/DC adaptor and replace REG1 with a full size LM7805 reg if you have issues.

Cheers
Jason

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

RagingRoosevelt, 2022-06-13:
> You could also run from an AC/DC adaptor and replace REG1 with a full size LM7805 reg if you have issues

The LM7805 would take 120v AC and convert it to 5v DC for the Le Strum?

Would another option be to set it up to use USB power directly and then just tie the midi plug into the usb power?  I was originally planning to use a micro usb breakout connected to a step up converter and a 9v battery adapter to USB power the thing, so maybe going directly from USB would work instead?
