hotchk155/Voici-Le-Strum/docs/Le Strum quick ref v5.pdf

C | C# | D | D# | E | F | F# | G | G# | A | A# | B
Le

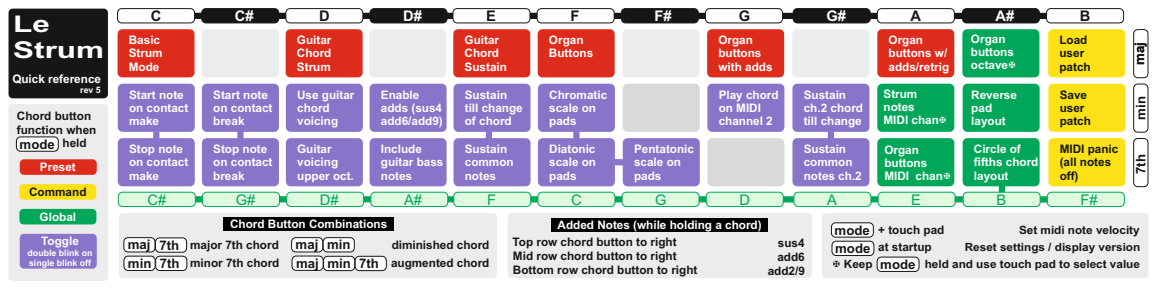
[picture p82: page 1]
Start note on contact make; Stop note on contact make; Basic Strum Mode; Start note on contact break; Stop note on contact break; Use guitar chord voicing; Guitar voicing upper oct.; Guitar Chord Strum; Enable adds (sus4 add6/add9); Include guitar bass notes; Sustain till change of chord; Sustain common notes; Guitar Chord Sustain; Chromatic scale on pads; Diatonic scale on pads; Organ Buttons; Pentatonic scale on pads; Play chord on MIDI channel 2; Organ buttons with adds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

Chord Button Combinations

Added Notes (while holding a chord)

Toggle
double blink on
single blink off

Set midi note velocity

Top row chord button to right
Mid row chord button to right
Bottom row chord button to right
