hotchk155/Voici-Le-Strum/le_grand_strum/le_grand_strum.brd

## EAGLE design le_grand_strum/le_grand_strum.brd (2024-11-19)

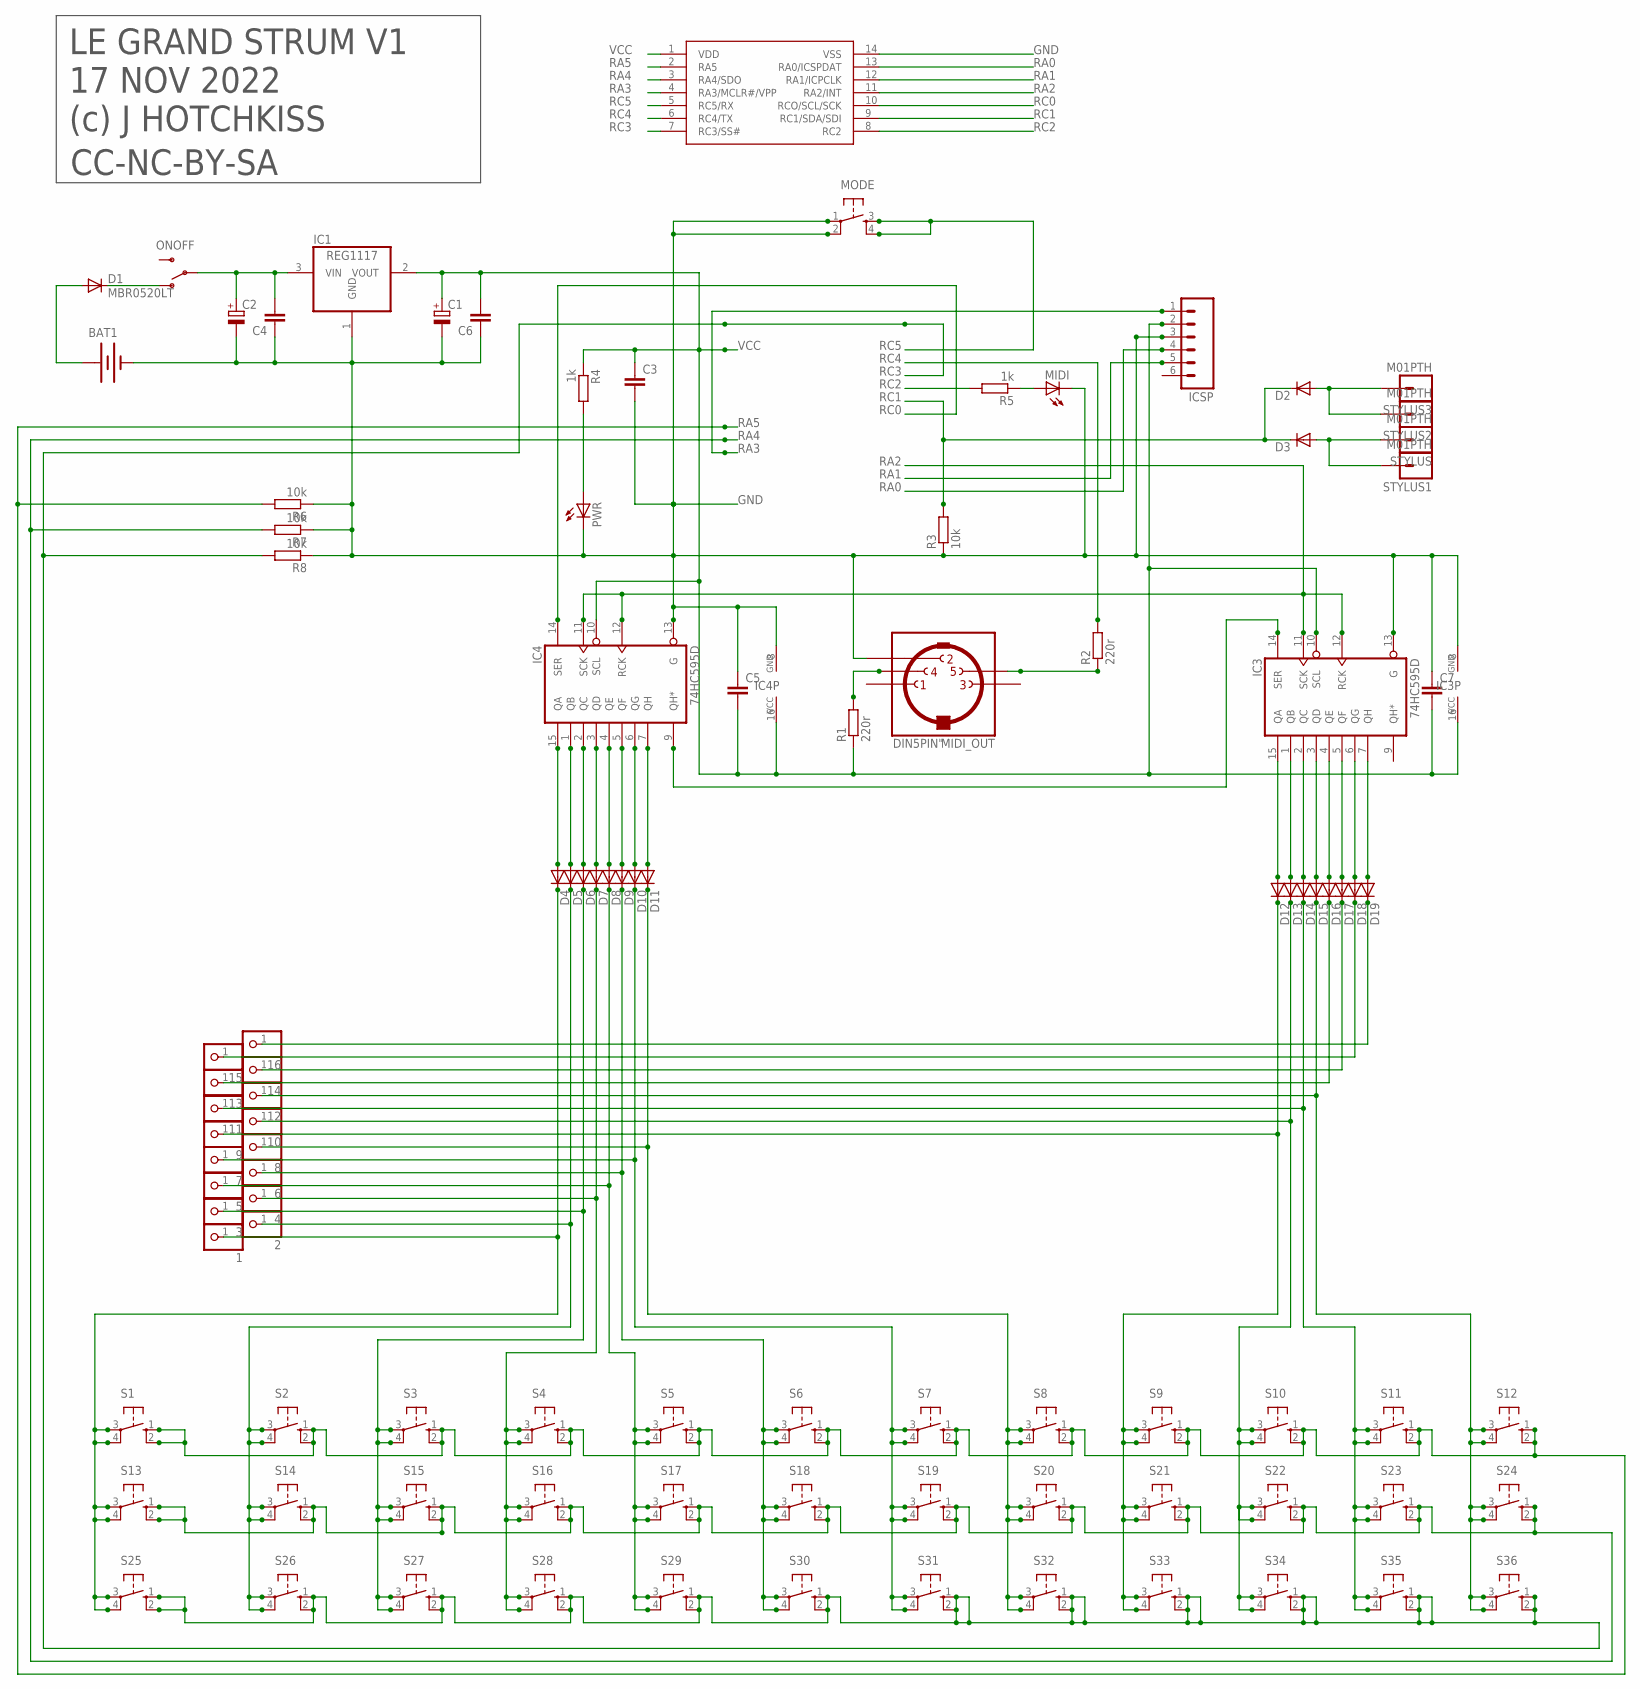
[picture p83: schematic le_grand_strum.sch]

Parts:
1, 2, 3, 4, 5, 6, 7, 8, 9, 10, 11, 12, 13, 14, 15, 16: PINHD-1X1; 1X01
BAT1: BATTERY2HOLES; PP3_BATTERBOX2
C1, C2: CPOL-EUE2-5; E2-5
C3, C4, C5, C6, C7: C-EUC0805; C0805
D1: MBR0520LT; SOD123
D2, D3, D4, D5, D6, D7, D8, D9, D10, D11, D12, D13, D14, D15, D16, D17, D18, D19: TS4148; D0805
IC1: REG1117; SOT223
IC2: PIC16F1825SO14; SO14
IC3, IC4: 74HC595D; SO16
ICSP: M06SIP; 1X06
MIDI: LEDCHIPLED_0805; CHIPLED_0805
MIDI_OUT: DIN5PIN"; TRUCONN90
MODE: TAC_SWITCHPTH; TACTILE-PTH
ONOFF: SWITCH-SPSTPTH; SWITCH-SPDT
PWR: LEDCHIPLED_0805; CHIPLED_0805
R1, R2: 220r; R0805
R3, R6, R7, R8: 10k; R0805
R4, R5: 1k; R0805
S1, S2, S3, S4, S5, S6, S7, S8, S9, S10, S11, S12, S13, S14, S15, S16, S17, S18, S19, S20, S21, S22, S23, S24, S25, S26, S27, S28, S29, S30, S31, S32, S33, S34, S35, S36: 40-XX; B3F-40XX
STYLUS, STYLUS1, STYLUS2, STYLUS3: M01PTH; 1X01

Connections:
CARRY: IC3.14 (SER), IC4.9 (QH*)
GND: BAT1.0V (-), C1.-, C2.-, C3.2, C4.1, C5.1, C6.1, C7.1, IC1.1 (GND), IC2.14 (VSS), IC3.8 (GND), IC3.13 (G), IC4.8 (GND), IC4.13 (G), ICSP.3, MIDI.C, MIDI_OUT.2, MODE.1, MODE.2, PWR.C, R3.1, R6.1, R7.1, R8.1
LINE1: 1.1, D4.K (C), S1.3, S1.4 (P1), S13.3, S13.4 (P1), S25.3, S25.4 (P1)
LINE2: 2.1, D5.K (C), S2.3, S2.4 (P1), S14.3, S14.4 (P1), S26.3, S26.4 (P1)
LINE3: 3.1, D6.K (C), S3.3, S3.4 (P1), S15.3, S15.4 (P1), S27.3, S27.4 (P1)
LINE4: 4.1, D7.K (C), S4.3, S4.4 (P1), S16.3, S16.4 (P1), S28.3, S28.4 (P1)
LINE5: 5.1, D8.K (C), S5.3, S5.4 (P1), S17.3, S17.4 (P1), S29.3, S29.4 (P1)
LINE6: 6.1, D9.K (C), S6.3, S6.4 (P1), S18.3, S18.4 (P1), S30.3, S30.4 (P1)
LINE7: 7.1, D10.K (C), S7.3, S7.4 (P1), S19.3, S19.4 (P1), S31.3, S31.4 (P1)
LINE8: 8.1, D11.K (C), S8.3, S8.4 (P1), S20.3, S20.4 (P1), S32.3, S32.4 (P1)
LINE9: 9.1, D12.K (C), S9.3, S9.4 (P1), S21.3, S21.4 (P1), S33.3, S33.4 (P1)
LINE10: 10.1, D13.K (C), S10.3, S10.4 (P1), S22.3, S22.4 (P1), S34.3, S34.4 (P1)
LINE11: 11.1, D14.K (C), S11.3, S11.4 (P1), S23.3, S23.4 (P1), S35.3, S35.4 (P1)
LINE12: 12.1, D15.K (C), S12.3, S12.4 (P1), S24.3, S24.4 (P1), S36.3, S36.4 (P1)
LINE13: 13.1, D16.K (C)
LINE14: 14.1, D17.K (C)
LINE15: 15.1, D18.K (C)
LINE16: 16.1, D19.K (C)
unnamed: PWR.A, R4.2
unnamed: BAT1.9V (+), D1.A
unnamed: D1.C, ONOFF.1 (O)
unnamed: D4.A, IC4.15 (QA)
unnamed: D5.A, IC4.1 (QB)
unnamed: D6.A, IC4.2 (QC)
unnamed: D7.A, IC4.3 (QD)
unnamed: D8.A, IC4.4 (QE)
unnamed: D9.A, IC4.5 (QF)
unnamed: D10.A, IC4.6 (QG)
unnamed: MIDI.A, R5.1
unnamed: D11.A, IC4.7 (QH)
unnamed: D12.A, IC3.15 (QA)
unnamed: D13.A, IC3.1 (QB)
unnamed: D14.A, IC3.2 (QC)
unnamed: D15.A, IC3.3 (QD)
unnamed: D16.A, IC3.4 (QE)
unnamed: D17.A, IC3.5 (QF)
unnamed: D18.A, IC3.6 (QG)
unnamed: D19.A, IC3.7 (QH)
unnamed: D2.A, STYLUS2.1, STYLUS3.1
unnamed: D3.A, STYLUS.1, STYLUS1.1
unnamed: MIDI_OUT.5, R2.1
unnamed: MIDI_OUT.4, R1.2
unnamed: C2.+, C4.2, IC1.3 (VIN), ONOFF.2
RA0: IC2.13 (RA0/ICSPDAT), ICSP.4
RA1: IC2.12 (RA1/ICPCLK), ICSP.5
RA2: IC2.11 (RA2/INT), IC3.11 (SCK), IC3.12 (RCK), IC4.11 (SCK), IC4.12 (RCK)
RA3: IC2.4 (RA3/MCLR#/VPP), ICSP.1
RA4: IC2.3 (RA4/SDO), R7.2, S13.1 (S), S13.2 (S1), S14.1 (S), S14.2 (S1), S15.1 (S), S15.2 (S1), S16.1 (S), S16.2 (S1), S17.1 (S), S17.2 (S1), S18.1 (S), S18.2 (S1), S19.1 (S), S19.2 (S1), S20.1 (S), S20.2 (S1), S21.1 (S), S21.2 (S1), S22.1 (S), S22.2 (S1), S23.1 (S), S23.2 (S1), S24.1 (S), S24.2 (S1)
RA5: IC2.2 (RA5), R6.2, S1.1 (S), S1.2 (S1), S2.1 (S), S2.2 (S1), S3.1 (S), S3.2 (S1), S4.1 (S), S4.2 (S1), S5.1 (S), S5.2 (S1), S6.1 (S), S6.2 (S1), S7.1 (S), S7.2 (S1), S8.1 (S), S8.2 (S1), S9.1 (S), S9.2 (S1), S10.1 (S), S10.2 (S1), S11.1 (S), S11.2 (S1), S12.1 (S), S12.2 (S1)
RC0: IC2.10 (RCO/SCL/SCK), IC4.14 (SER)
RC1: D2.K (C), D3.K (C), IC2.9 (RC1/SDA/SDI), R3.2
RC2: IC2.8 (RC2), R5.2
RC3: IC2.7 (RC3/SS#), R8.2, S25.1 (S), S25.2 (S1), S26.1 (S), S26.2 (S1), S27.1 (S), S27.2 (S1), S28.1 (S), S28.2 (S1), S29.1 (S), S29.2 (S1), S30.1 (S), S30.2 (S1), S31.1 (S), S31.2 (S1), S32.1 (S), S32.2 (S1), S33.1 (S), S33.2 (S1), S34.1 (S), S34.2 (S1), S35.1 (S), S35.2 (S1), S36.1 (S), S36.2 (S1)
RC4: IC2.6 (RC4/TX), R2.2
RC5: IC2.5 (RC5/RX), MODE.3, MODE.4
VCC: C1.+, C3.1, C5.2, C6.2, C7.2, IC1.2 (VOUT), IC2.1 (VDD), IC3.10 (SCL), IC3.16 (VCC), IC4.10 (SCL), IC4.16 (VCC), ICSP.2, R1.1, R4.1

Notes on the sheet:
LE GRAND STRUM V1
17 NOV 2022
(c) J HOTCHKISS
CC-NC-BY-SA

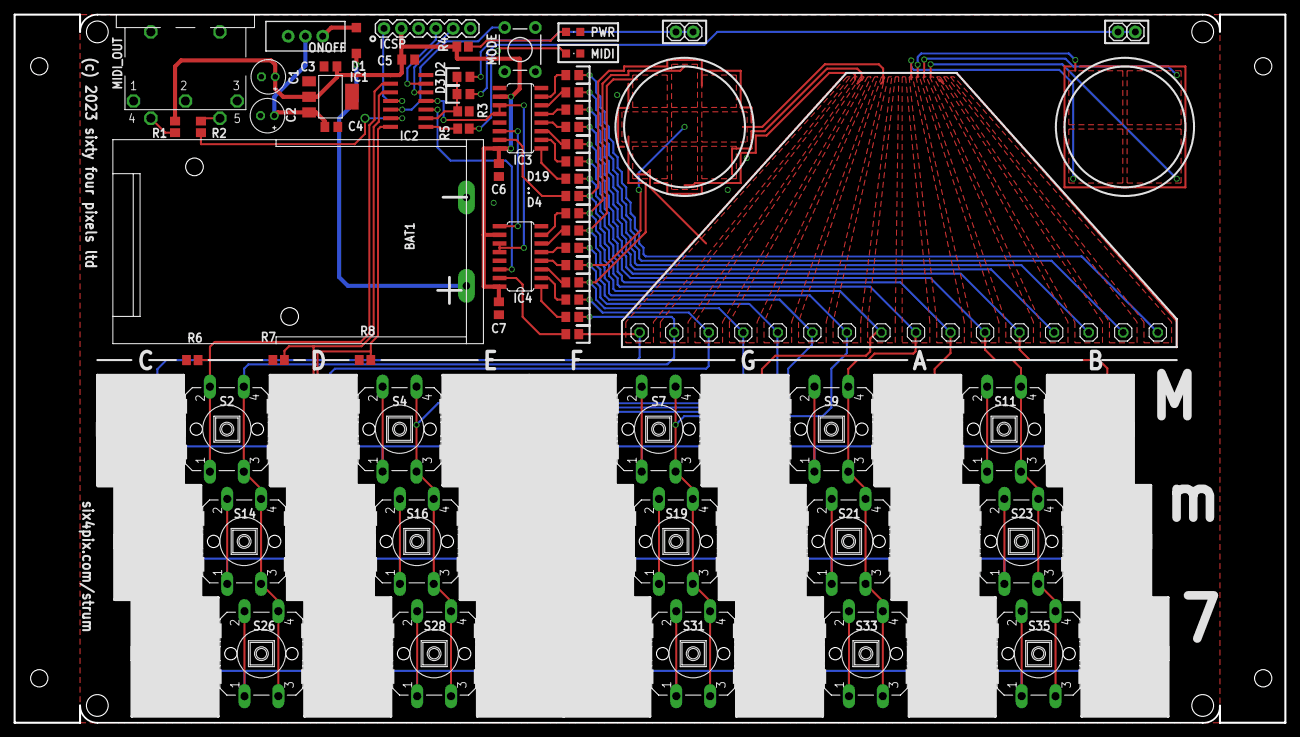
[picture p84: board le_grand_strum.brd from above]

Board: 2 copper layers, 186.9 x 104.1 mm, 101 parts (0 on the bottom side), 56 nets.
