hotchk155/Voici-Le-Strum/(commit log)

2013-02-12 changed to work with PIC16F1825 and new PCB
2013-02-25 eagle updates
    [le_strum.brd, le_strum.sch]
2013-06-22 fixes in firmware
    [le_strum.brd]
2013-07-07 Version 1.2 - reverse strum
    [StrumController.c]
2016-01-06 case BOM added
2018-08-21 Version 6
    Ability to set specific chord notes in "organ buttons" mode
2022-11-17 REV 1
    [strum2.brd, strum2.sch]
2022-11-17 FINAL V1
    [le_grand_strum.brd]
2022-11-17 even more final V1
    [le_grand_strum.brd, le_grand_strum.sch]
2023-01-11 rev2 board thru hole switches
    [le_grand_strum.brd, le_grand_strum.sch]
2024-11-19 VERSION 3
    ground midi out pin 2
    [le_grand_strum.brd, le_grand_strum.sch]
