hotchk155/Voici-Le-Strum/(notices)

Notices in the files:
le_grand_strum_stencil/le_grand_strum_stencil.brd:
(c) 2023 sixty four pixels ltd
